jibebe-jkuat/internship2023/README.md

# Jibebe internship 2023

[PPT Slide](https://docs.google.com/presentation/d/1Ak0KLYNTehpYL2wY0T9F-hz-qm3kGaumGBHkQSi8nZo/edit?usp=sharing)

(https://docs.google.com/presentation/d/1Ak0KLYNTehpYL2wY0T9F-hz-qm3kGaumGBHkQSi8nZo/edit?usp=sharing)
