jibebe-jkuat/internship2023/mechanical/Mechanical team 5.pptx

## WEEK 5 PROGRESS REPORT

## FABRICATION OF FAN MOUNT

The fan mount fabrication and installation was completed

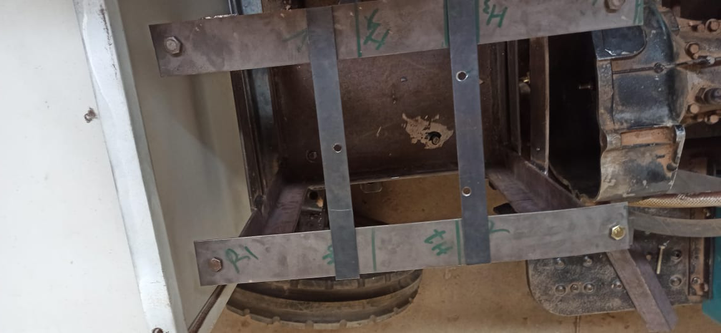
[picture p10: figure]

## Tasks this week

- Design the automated steering mechanism with navigation team
- Hydraulic pump mount and coupling

## BATTERY MOUNT DESIGN

The design was completed as shown below

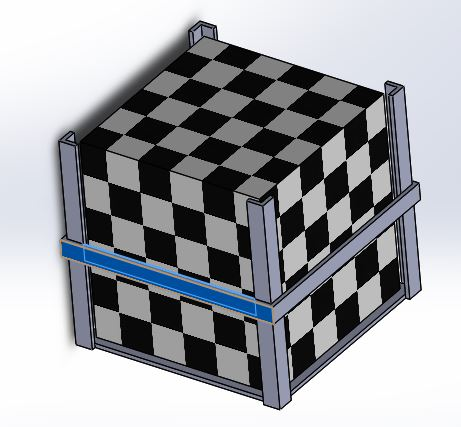
[picture p11: figure]

## BATTERY MOUNT FABRICATION AND INSTALLATION

The battery was installed with its casing for safety purposes and to minimise on material usage as shown

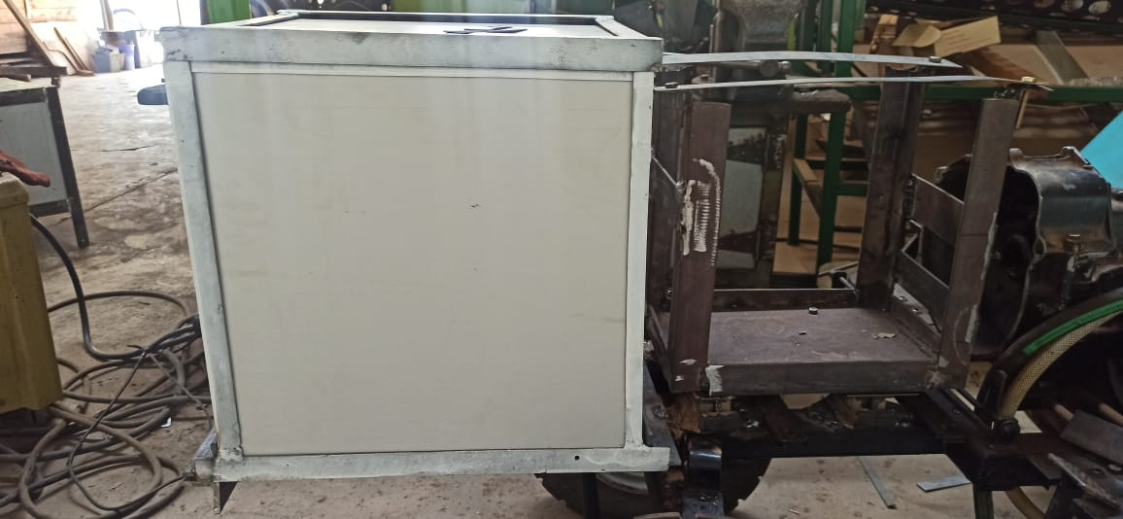
[picture p12: figure]

## EXTENSION OF THE CHASIS

The chassis was extended using a boxshaft to prevent the battery from overhanging.

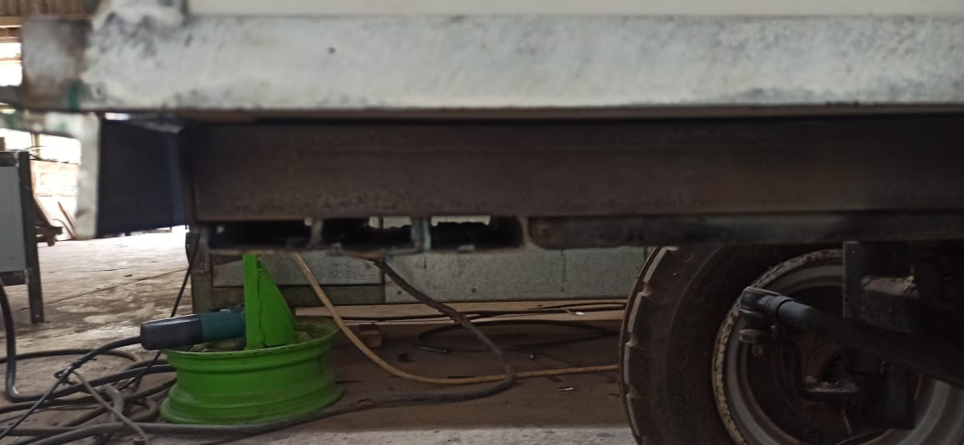
[picture p13: figure]

## ACQUISITION OF THE FLY WHEEL

The flywheel was unmounted from one of the Shujaa tractors in the BEED workshop as shown

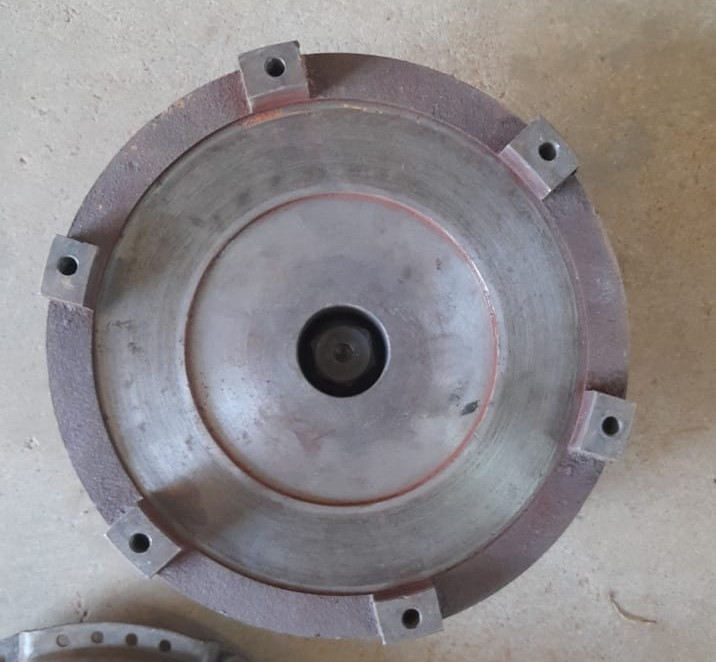
[picture p14: figure]

## 3D CAD REPRESENTATION

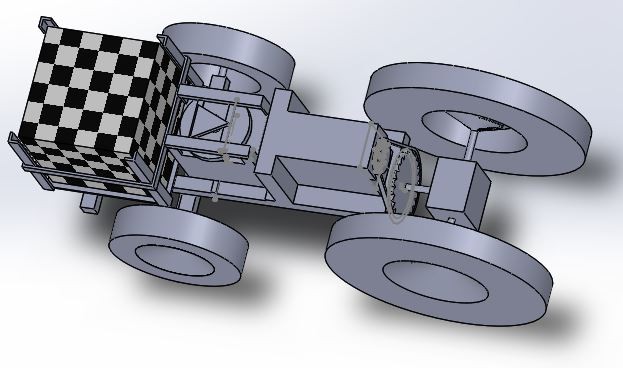
[picture p15: figure]
