jibebe-jkuat/internship2023/mechanical/Mechanical team 10.pptx

## MECHANICAL TEAM WEEK 10 PROGRESS REPORT

MEMBERS
1. Ian Mutisya
2. Isaac Ngugi
3. Peter Nzioki
4. Clinton Otieno
5. Catherine Kipkazi
6. Kennedy Ouma

## Tasks done

Wheelbase modification
Steering fabrication
Taper turning

## Taper turning

Taper was done to the flywheel-motor coupling. This was done so that it can fit into the flywheel bore.
It was done using a lathe machine in the machine shop
Key cutting is still in progress

## Wheelbase modification

By assuming the whole tractor being a simply supported beam and the wheels to be the supports, calculations were done so as to determine the new front wheel position.
We were able to extend the wheelbase by 200mm after calculations.
ASSUMPTIONS
The tractor was assumed to be a simply supported beam with the wheels as the reaction points.
The modification balanced out the reactions at the wheels to Ra=Rb to be 4.8kN.

## Slide 5

Before the modification,the reaction force at the front wheels was 5.2kN, & the rear 4.4kN. This added load to the front wheels increases tire load and steering load making turning difficult and unstable on banked road surfaces. The rear had reduced tire load increasing risk of slippage.since the tractor’s torque is transmitted to them. Reduced traction at the rear will impede operations on soft agricultural soils and in wet conditions.
Balancing of the tire load enables;
-less steering force
- pitching is minimized
-yawing chances are significantly reduced.

## FLIP ORIENTATION

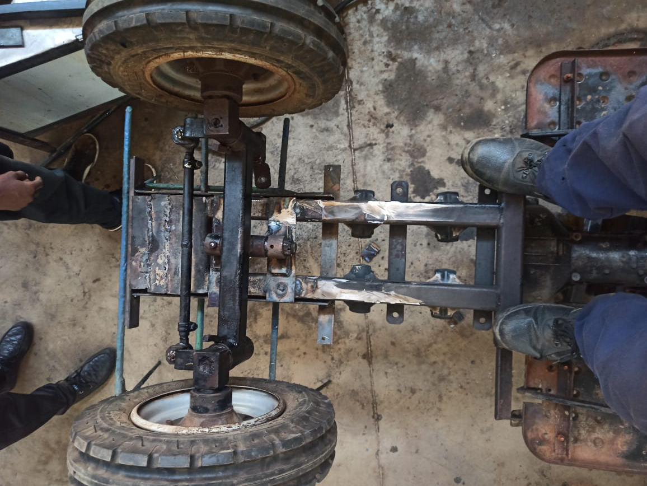
[picture p18: figure]

## TOP VIEW ORIENTATION

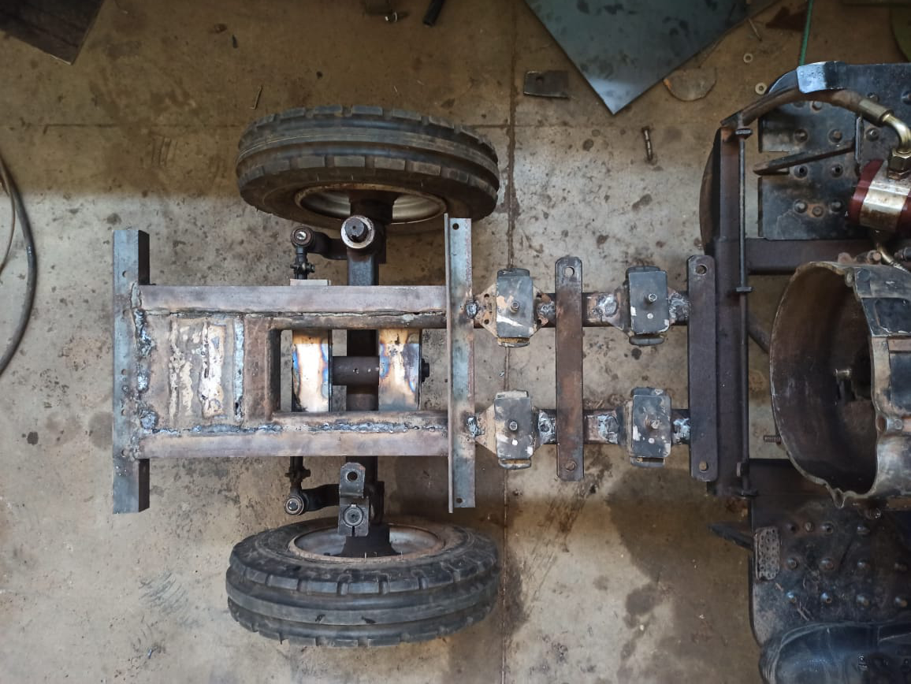
[picture p19: figure]

## STEERING INSTALLATION PROCESS

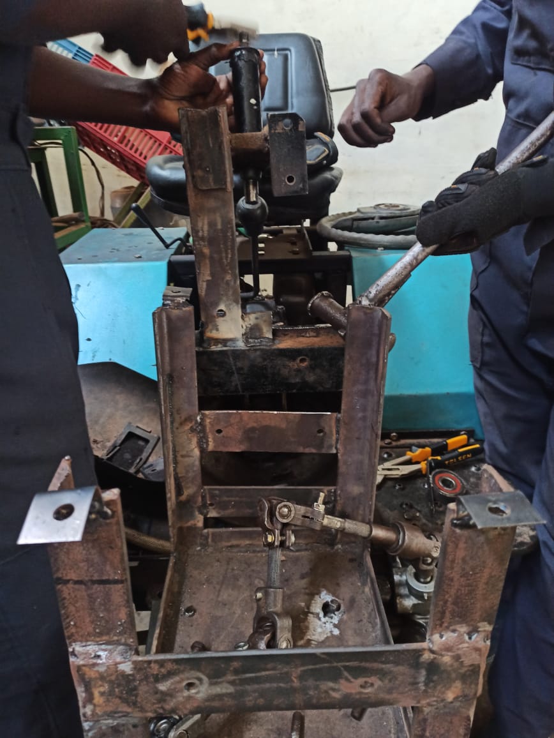
[picture p20: figure]

## STEERING

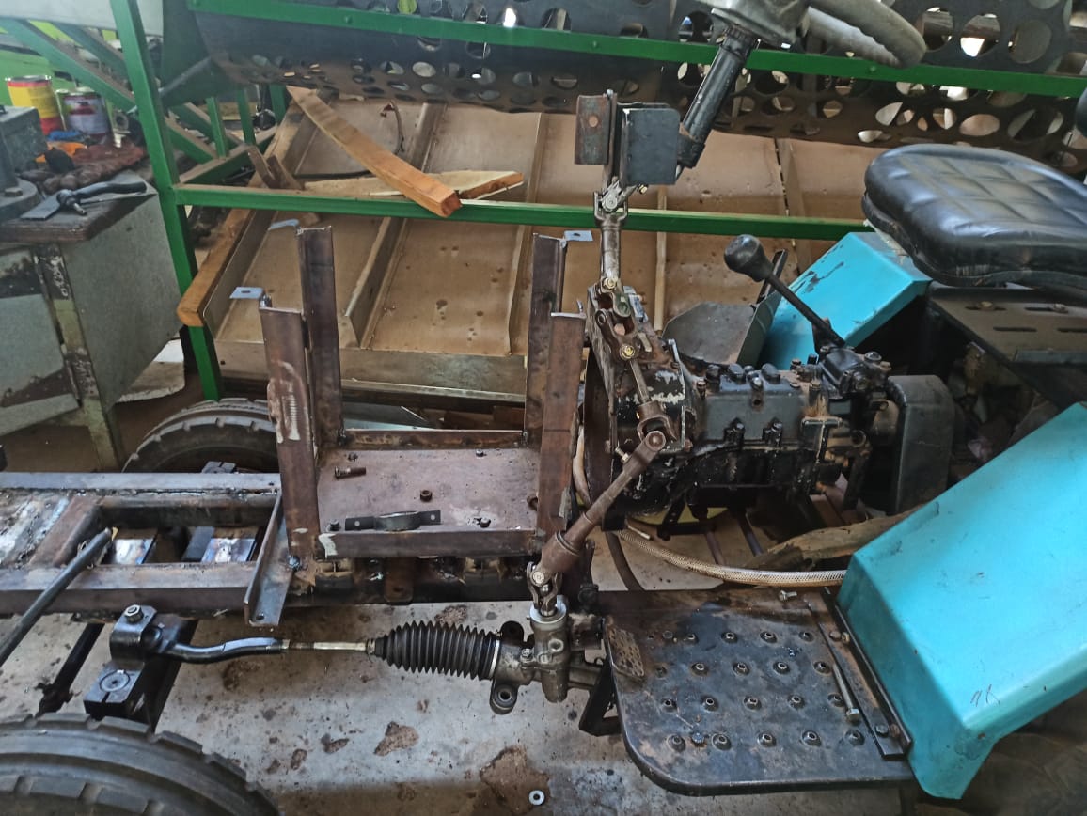
[picture p21: figure]

## KEYED AND TAPERED

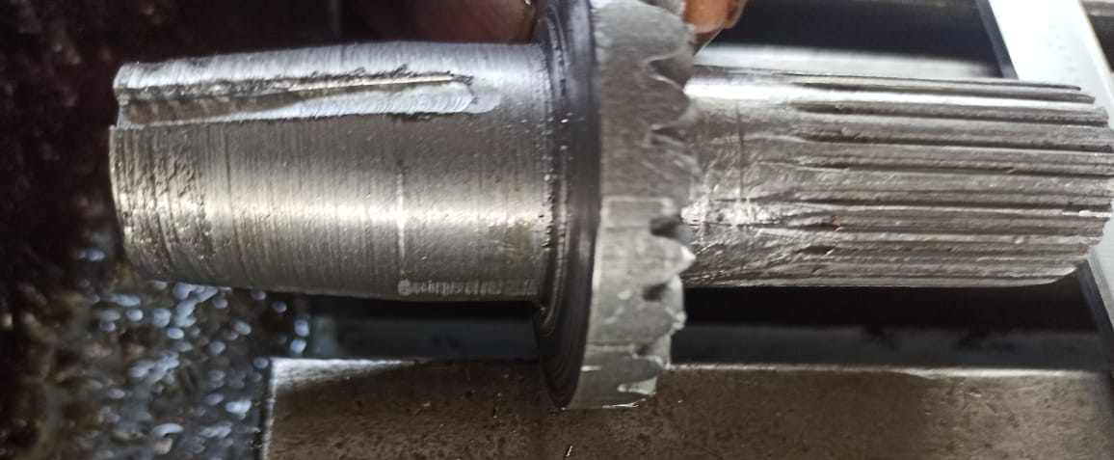
[picture p22: figure]

## Slide 11

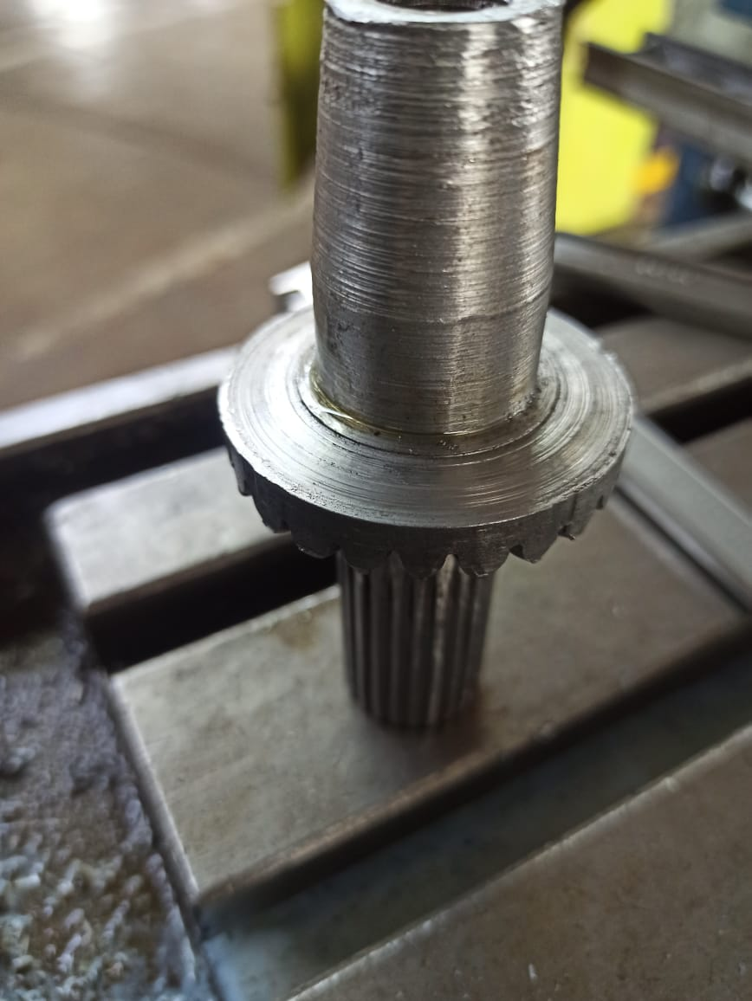
[picture p23: figure]

## Slide 12

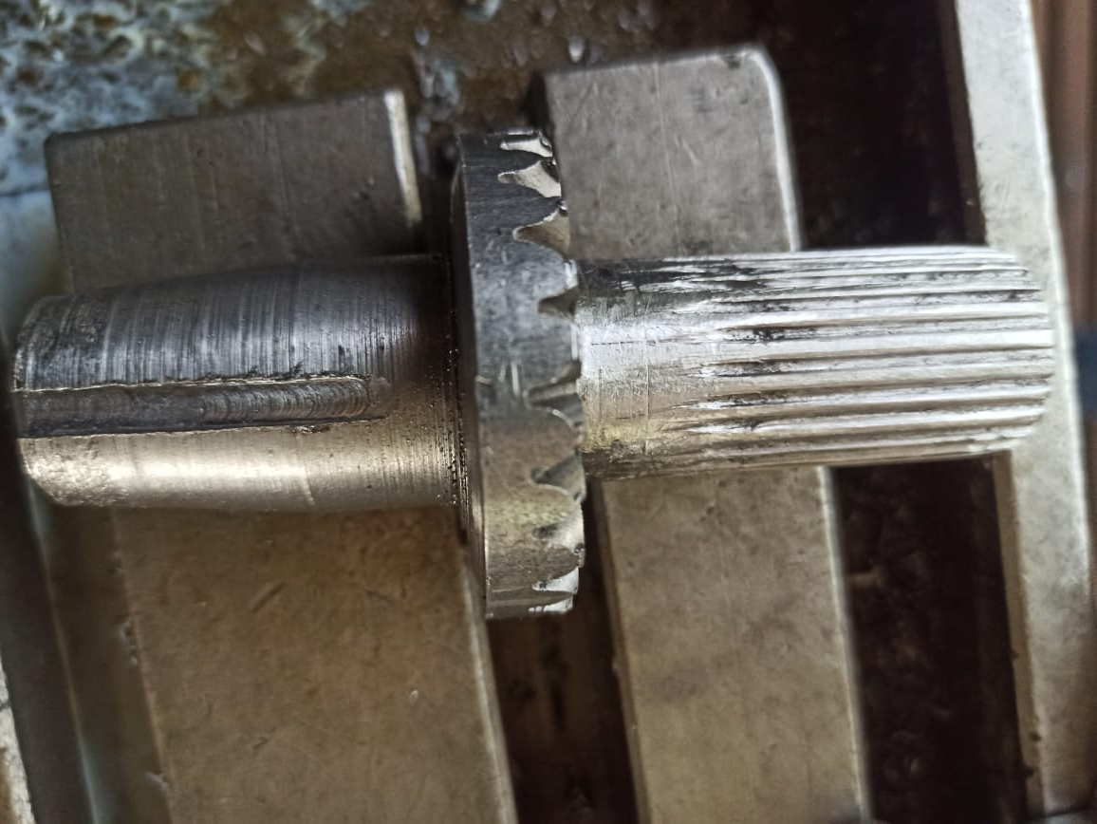
[picture p24: figure]

## Slide 13

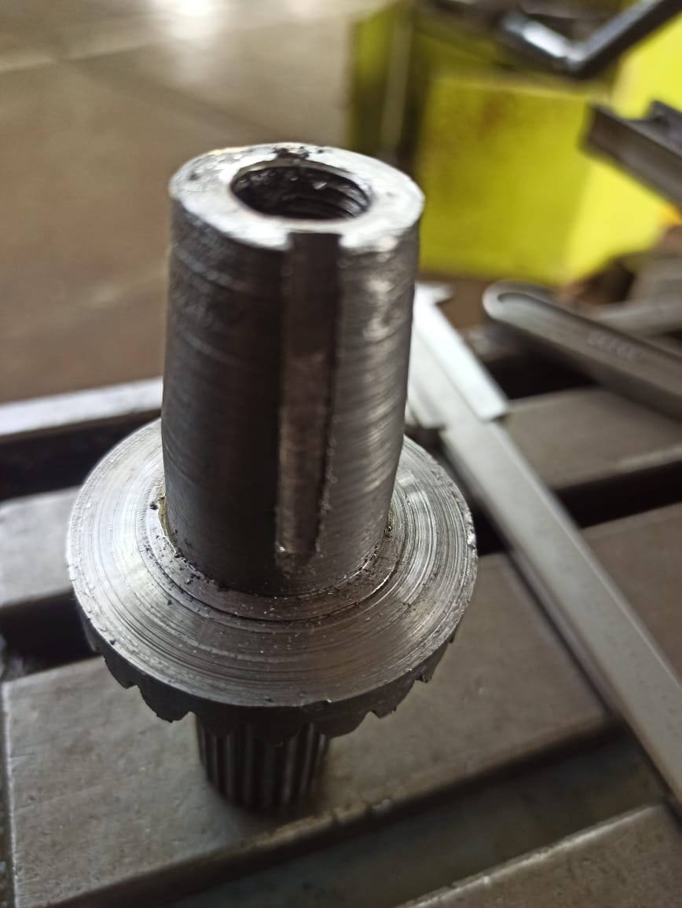
[picture p25: figure]
