jibebe-jkuat/internship2023/mechanical/Mechanical team 9.pptx

## MECHANICAL TEAM WEEK 9

Clinton Otieno

## Tasks done

Unmounting the front wheels and axle
Motor flywheel coupling machining

## FRONT WHEEL UNMOUNTING

This was done with an aim to extend the wheel base .
Extending the wheelbase will increase tractor balance thus reducing the tendency to roll when negotiating corners.

## WHEEL BASE EXTENSION IN PROGRESS

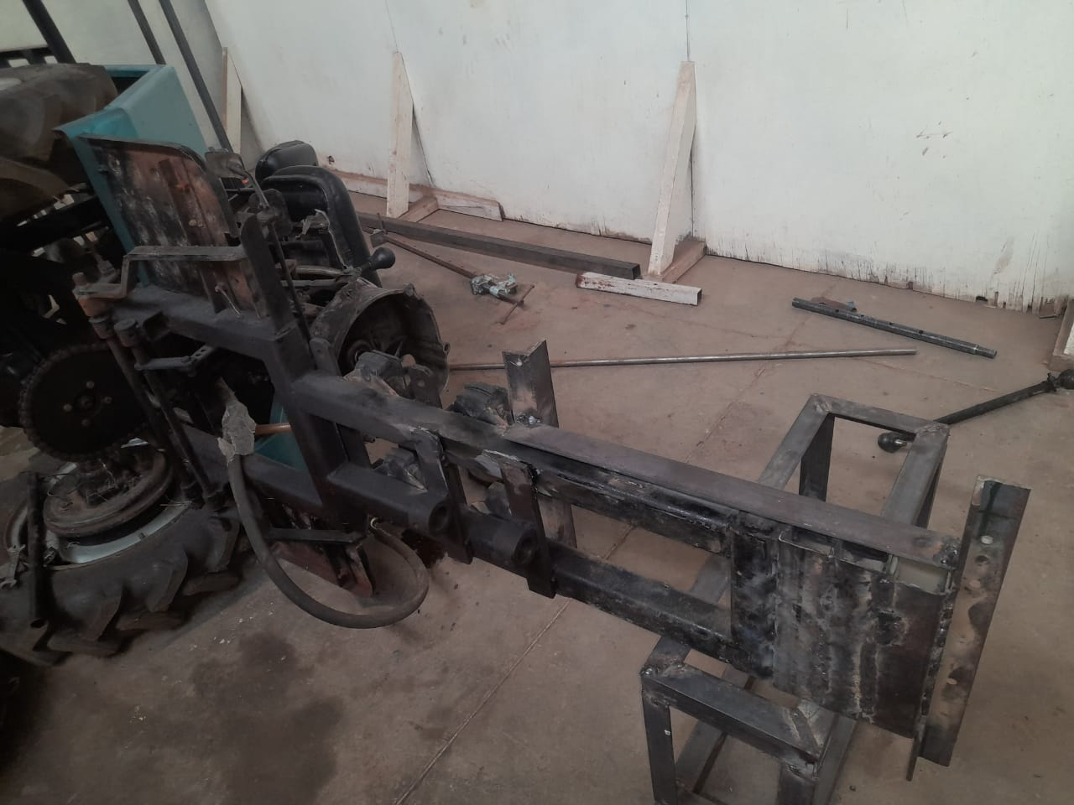
[picture p26: figure]

## MOTOR FLYWHEEL COUPLING

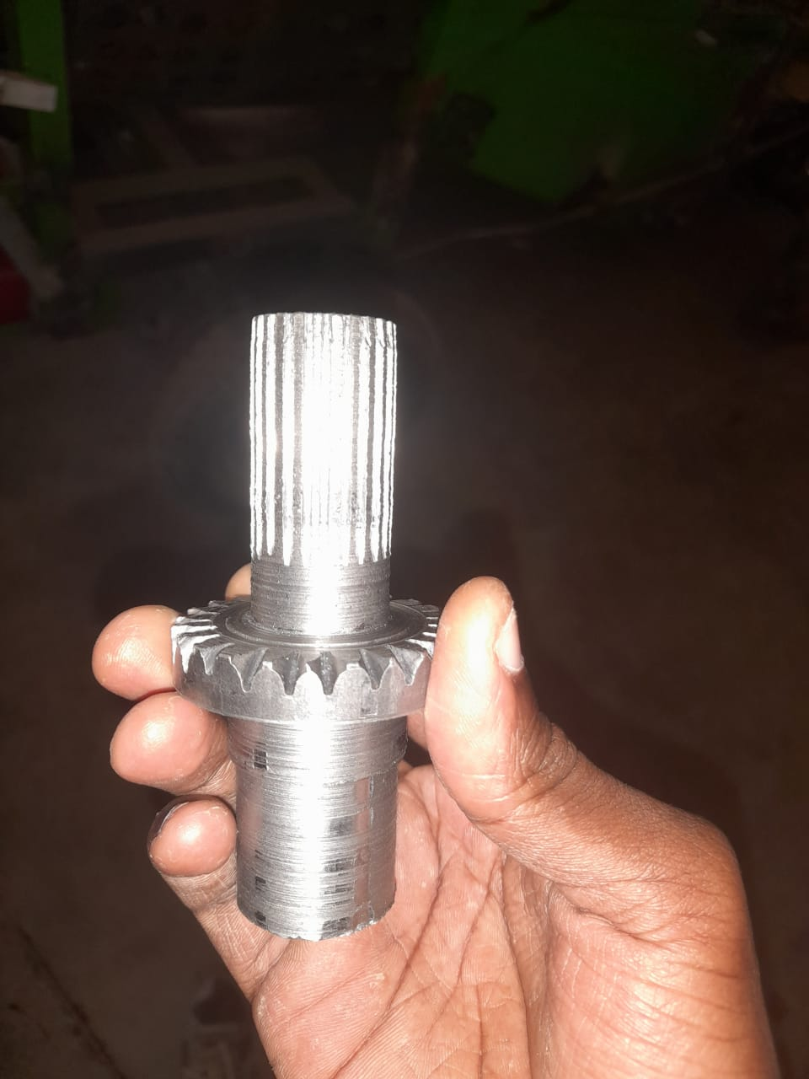
[picture p27: figure]

## FLYWHEEL COUPLING AND MOTOR

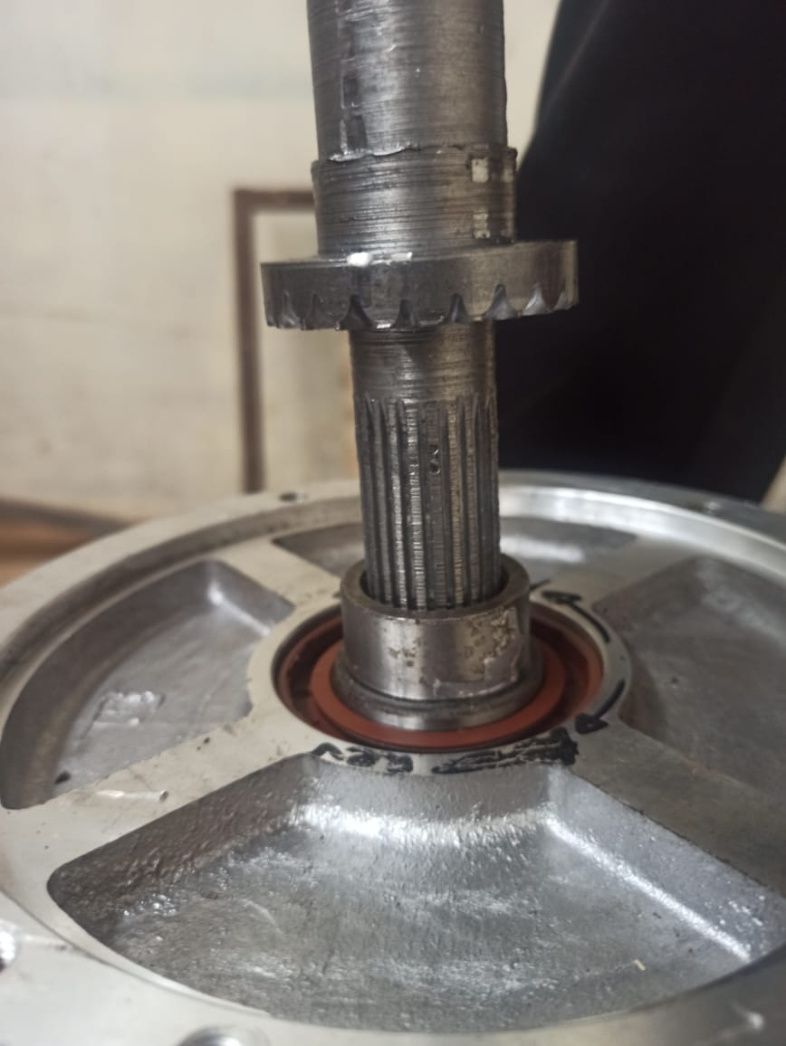
[picture p28: figure]

## THREADED PART

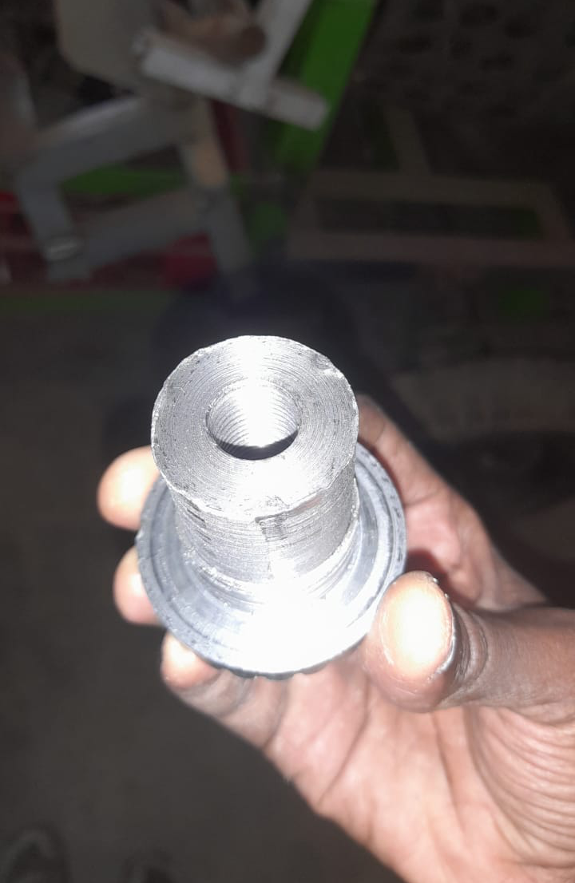
[picture p29: figure]

## MODIFIED RACK

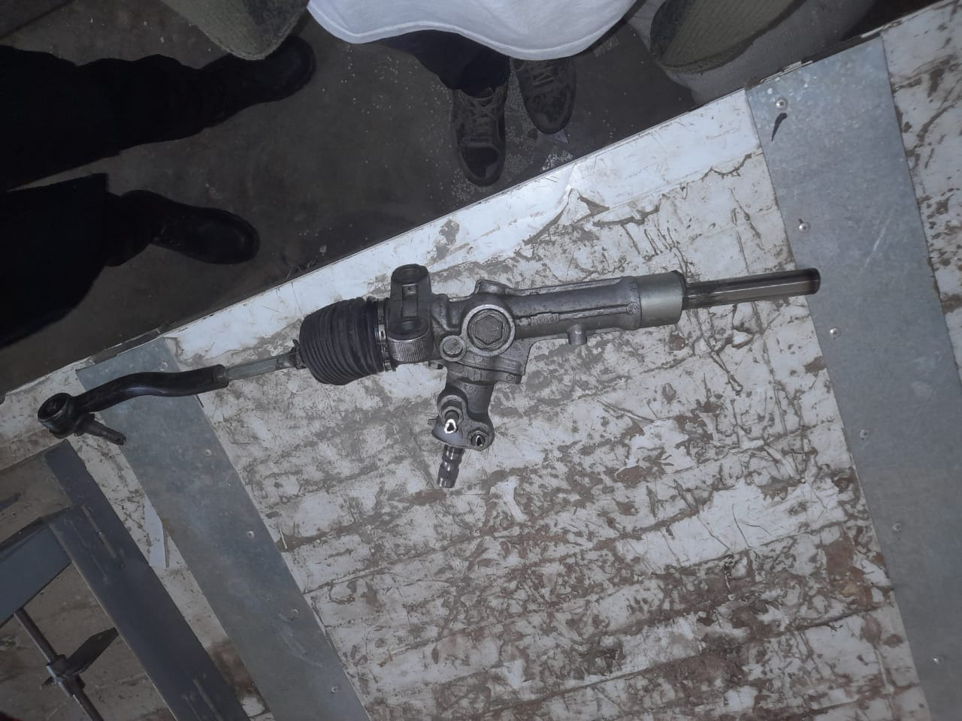
[picture p30: figure]

## CHALLENGE

Tools acquisition

## TO DO

Extension of wheel base
Finishing on the motor flywheel coupling fabrication
Completion of steering system fabrication
