jibebe-jkuat/internship2023/mechanical/Mechanical team 6.pptx

## JIBEBE MECHANICAL WEEK 6

Ian Mutisya

## TASKS COMPLETED THIS WEEK Selection of motor for hydraulic pump albeit pending calculations (will be done in consultation with electrical team). Design of new steering system Final dimensioning and design of flywheel coupling Improvement of 3D model

## HYDRAULIC PUMP MOTOR SPECIFICATIONS

We researched and found that a similar electric hydraulic pump of same capacity uses a 60W 12V motor,hence our choice power is a 70W one so as to accommodate the different implements to be used

## Slide 4

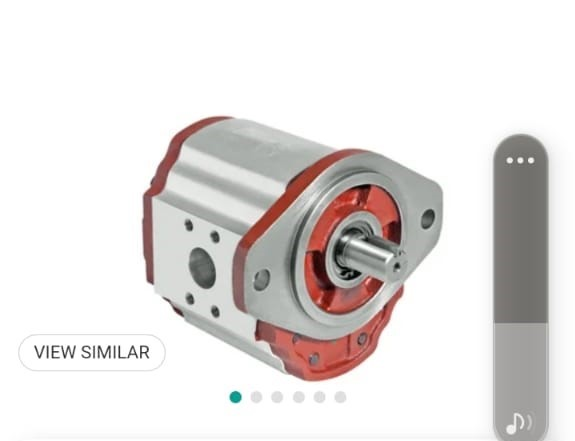
[picture p50: figure]
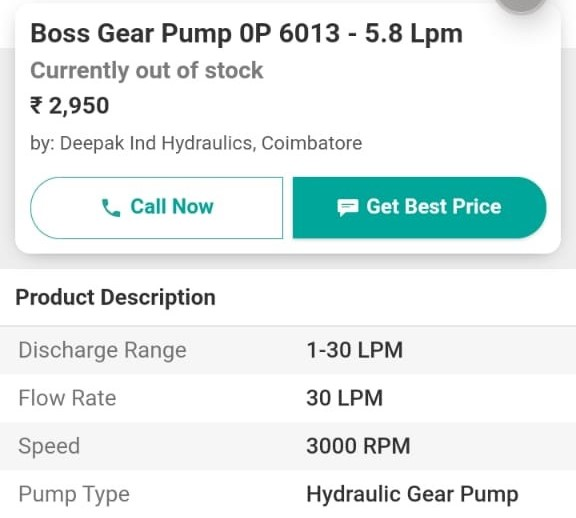
[picture p51: figure]

## Slide 5

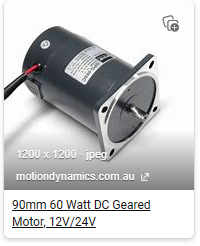
[picture p52: figure]
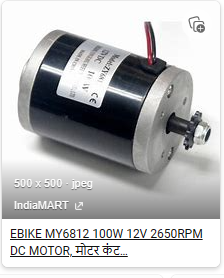
[picture p53: figure]

## STEERING DESIGN

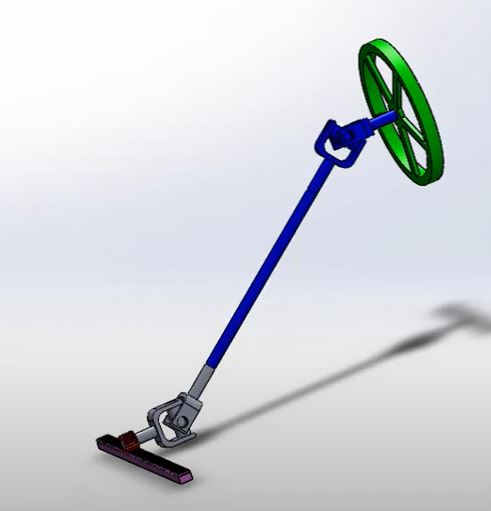
[picture p54: figure]

## WHY A NEW DESIGN?

The other steering had play leading to over steering and under steering
The battery size does not leave enough space for the previous model
The rack and pinion design allows for easier rotation of the steering wheel

## TO DO

Outsourcing the motor flywheel coupling
Hydraulic pump motor acquisition
Steering design and fabrication

## 3D REPRESENTATION

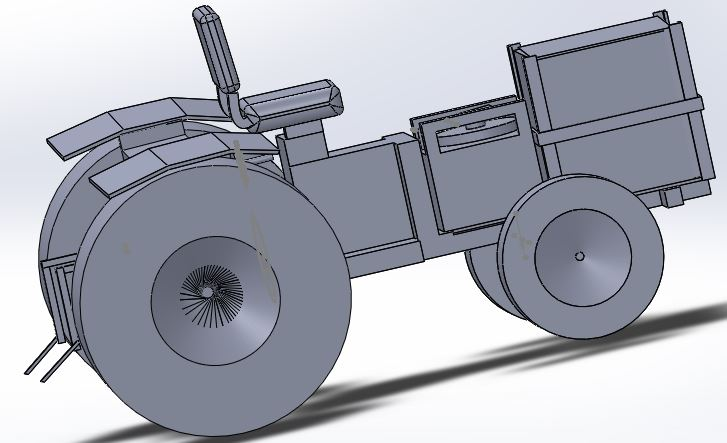
[picture p55: figure]
