jibebe-jkuat/internship2023/mechanical/Mechanical team 4.pptx

## MECHANICAL TEAM WEEK 4 PROGRESS REPORT

TEAM
CLINTON TITO
IAN MUTISYA
CATHERINE KIPKAZI
ISAAC NGUGI
KENNEDY OUMA
PETER NZIOKI

## PREVIOUS DESIGN CHALLENGE

- Had thick plates which was later realized to increase the weight the motor mount
- Use of plates on the sides obstructed air flow hence reducing cooling efficiency

## Slide 3

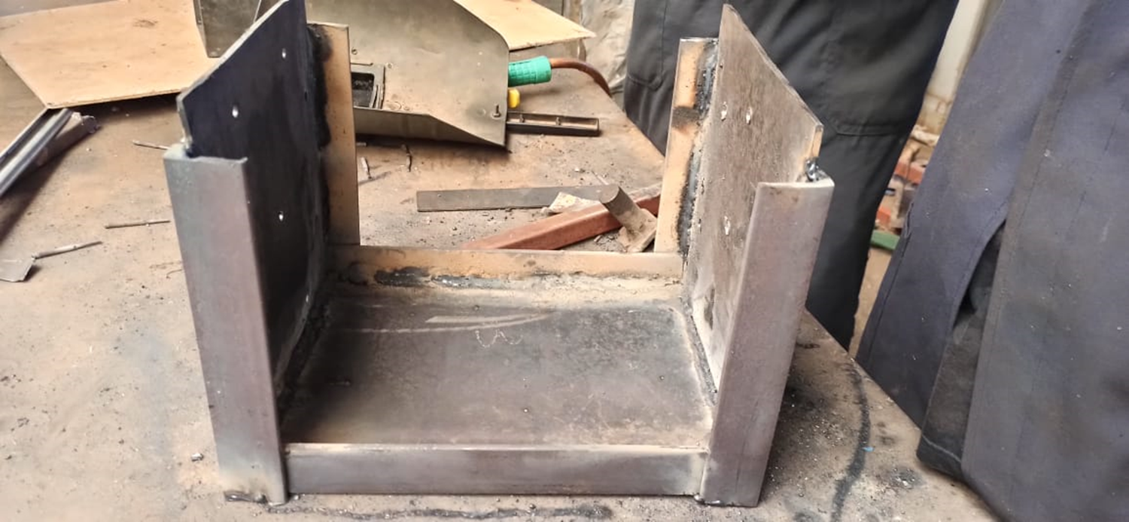
[picture p56: figure]

## WHY NEW DESIGN

- More cooling efficiency
- Lighter due to less materials as compared to the previous design

## MOTOR MOUNT WITHOUT THE MOTOR

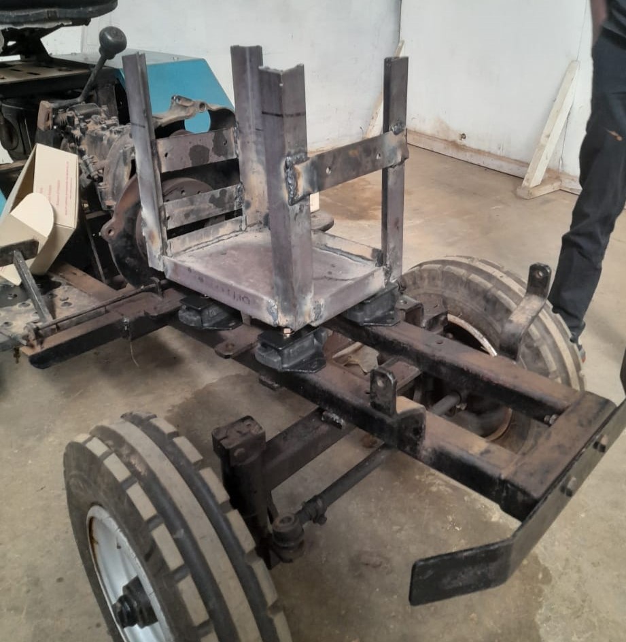
[picture p57: figure]

## SIDE VIEW

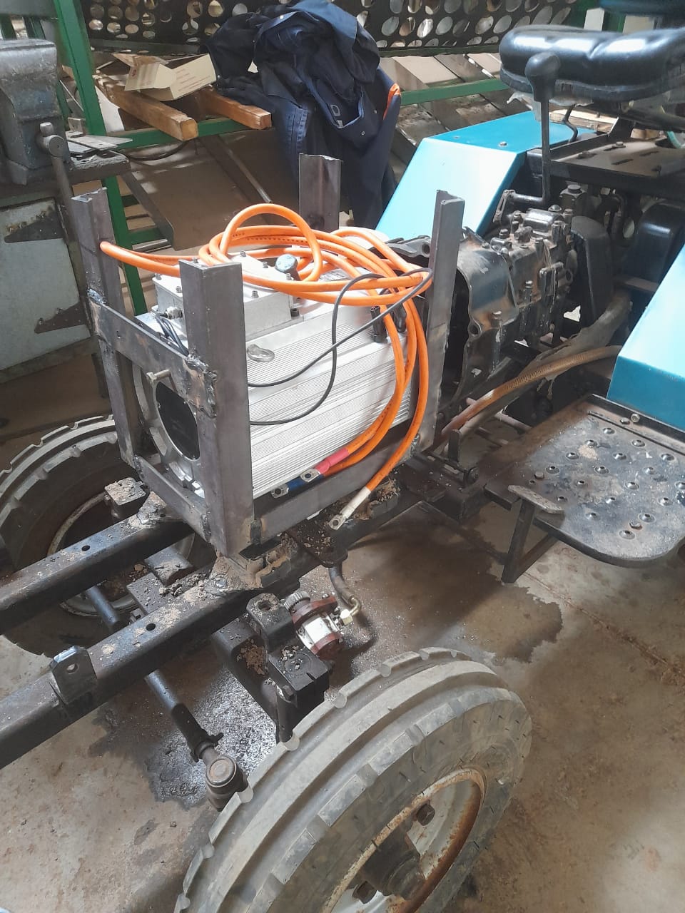
[picture p58: figure]

## RUBBER MOUNT ON THE CHASSIS

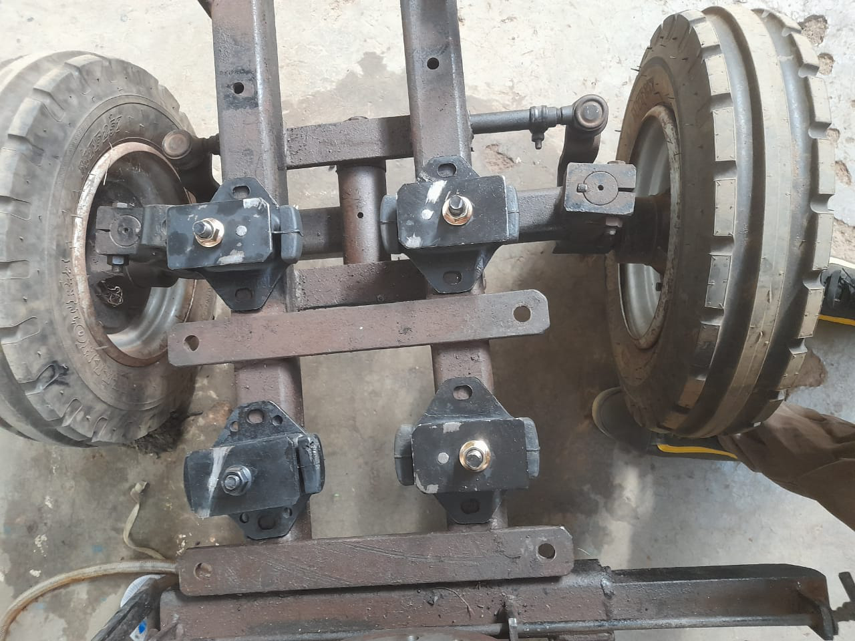
[picture p59: figure]

## TOP VIEW

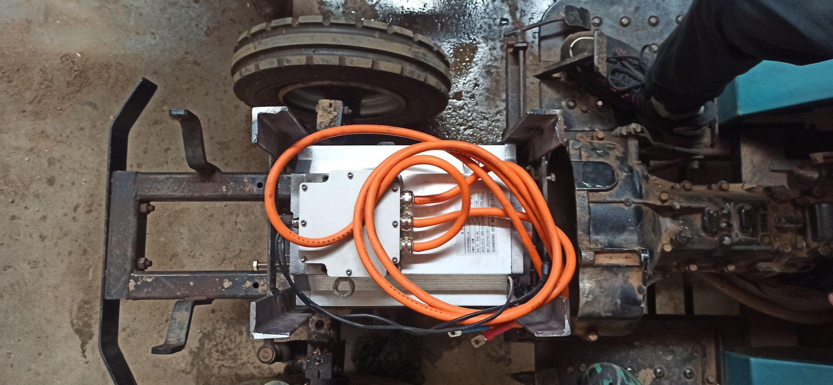
[picture p60: figure]

## FLYWHEEL COUPLING PURPOSE

To transmit power from motor to the gearbox

## FLYWHEEL COUPLING CAD DESIGN

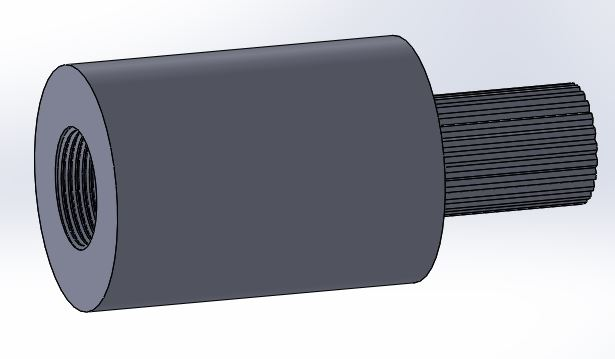
[picture p61: figure]

## TRACTOR 3D CAD REPRESENTATION

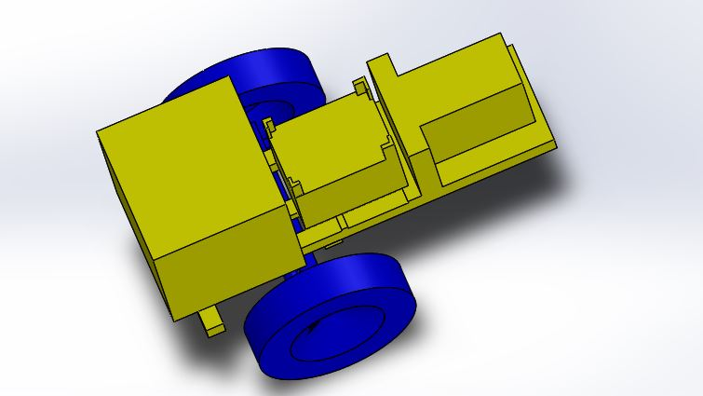
[picture p62: figure]

## THANK YOU

🤗
