jibebe-jkuat/internship2023/mechanical/Mechanical team 3.pptx

## JIBEBE MECHANICAL TEAM WEEK 3

Catherine kipkazi

## TASKS COMPLETED

Fabrication of motor mount
Fabrication of electric fan mount
Completion of final design work of battery mount

## MATERIAL ACQUISITION

We were able to acquire some materials to kickstart the fabrication process eg
Consumables
Angle lines
Plates

## FABRICATION

We began the fabrication of the motor mount.

## Slide 5

M

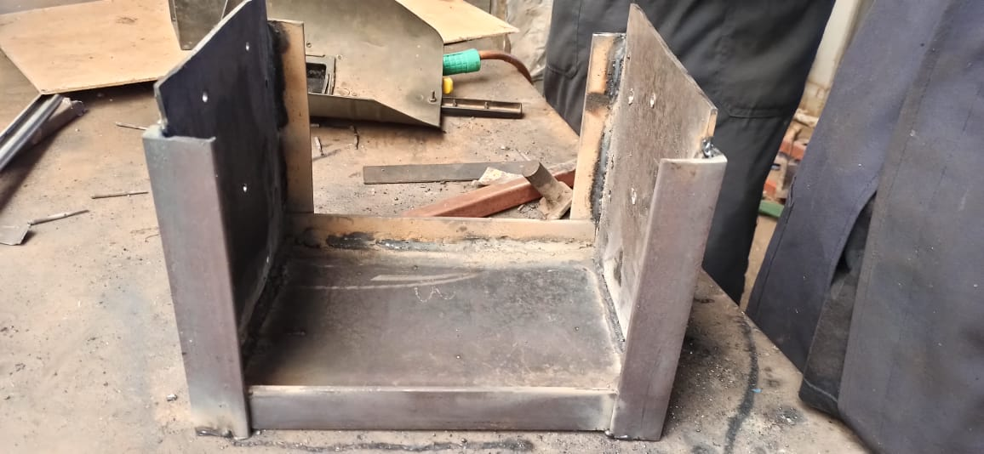
[picture p63: figure]

## TASKS THIS WEEK

Acquisition of materials
Installation of motor mount
Fabrication of battery mount
Design of flywheel-clutch coupling
