jibebe-jkuat/internship2023/mechanical/Mechanical team 2.pptx

## JIBEBE MECHANICAL TEAM WEEK 2

Kenedy Ouma

## MODIFICATION OF MOTOR AND BATTERY MOUNT DESIGN

This was to better suit the applicability ie. so that it may accomodate and support both the motor and the battery .

## Slide 3

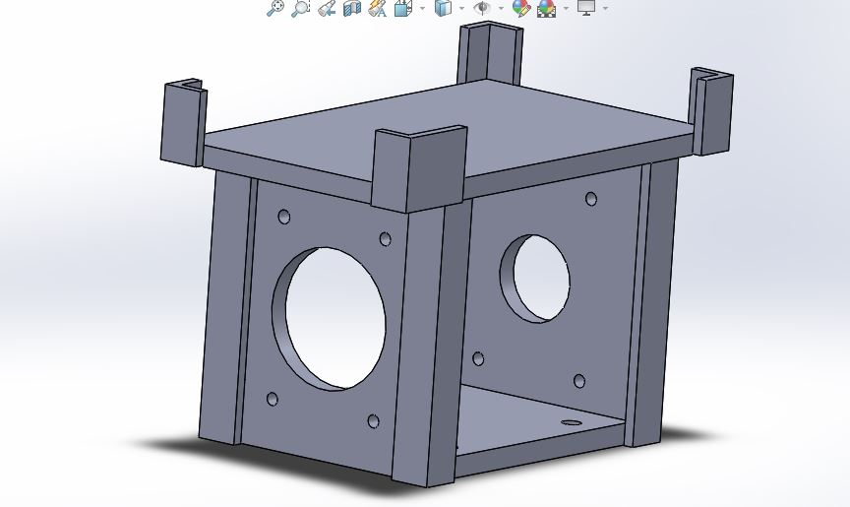
[picture p64: figure]

## Slide 4

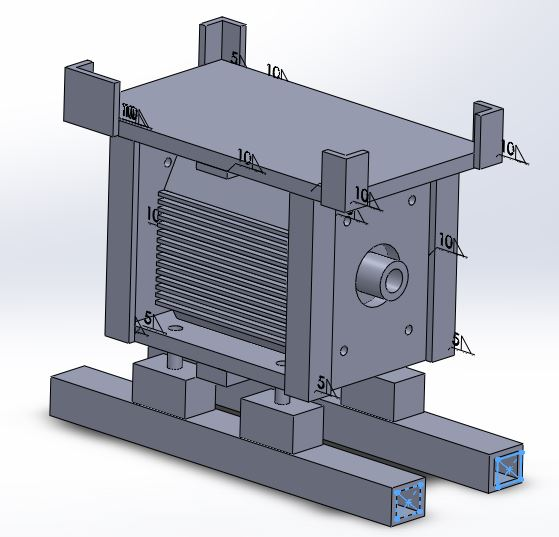
[picture p65: figure]

## SIMULATION OF THE DESIGN

From the simulation we deduced that:
The material will be mild steel
Mild steel sheets of a 20mm width
Angle lines : 2 in by 2 in by 5mm

## Slide 6

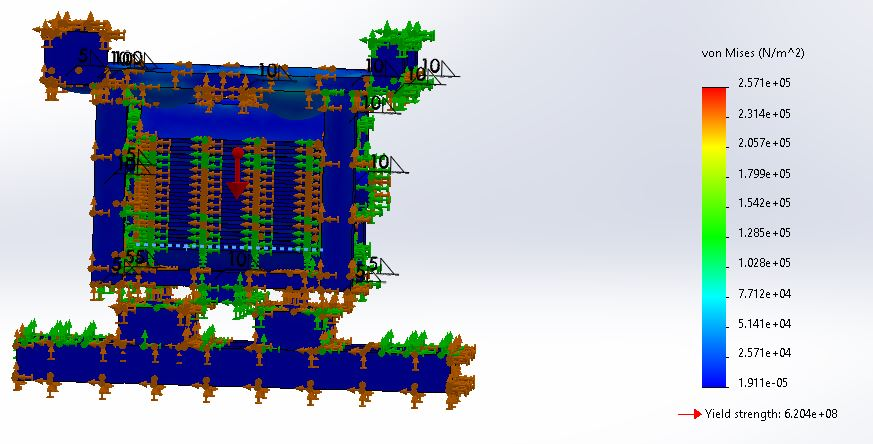
[picture p66: figure]

## Slide 7

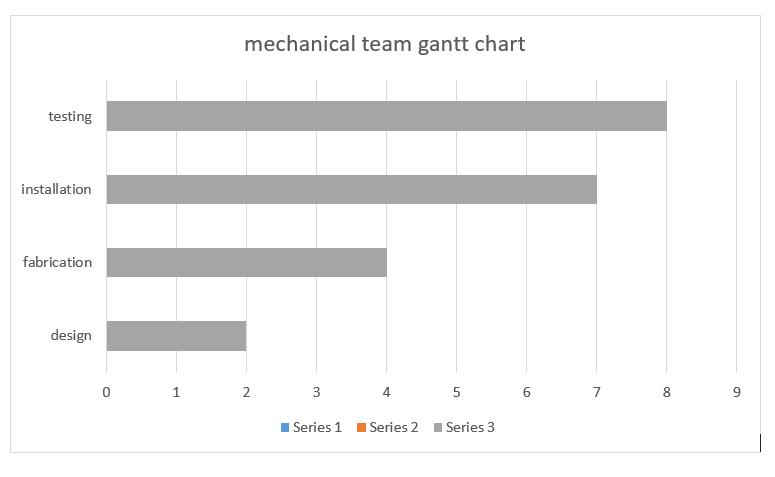
[picture p67: figure]

## ACQUISITION OF MATERIALS

We have acquired the quotations of the materials needed to kick off fabrication process

## Slide 9

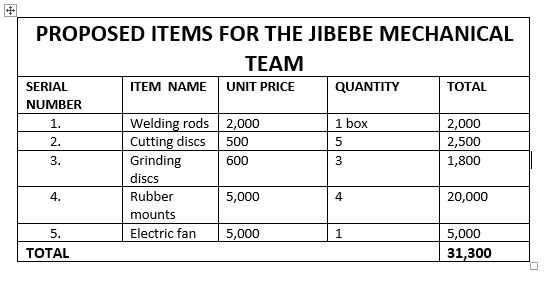
[picture p68: figure]

## Slide 10

THANK
YOU
😀
