jibebe-jkuat/internship2023/mechanical/Mechanical team 1.pptx

## JIBEBE MECHANICAL TEAM

WEEK ONE

## TRACTOR PERFORMANCE TESTING

The hydraulic and braking system were in a good condition.
The gearbox was also working properly.
Traction
- Small wheels causing insufficient traction.
Stability
- Uneven weight distribution causing a tendency to pitch or roll.
Steering
- Steering play leading to over steering and under steering.

## TRACTOR DISASSEMBLY

Unmounting the engine
Disassembling the clutch

## Slide 4

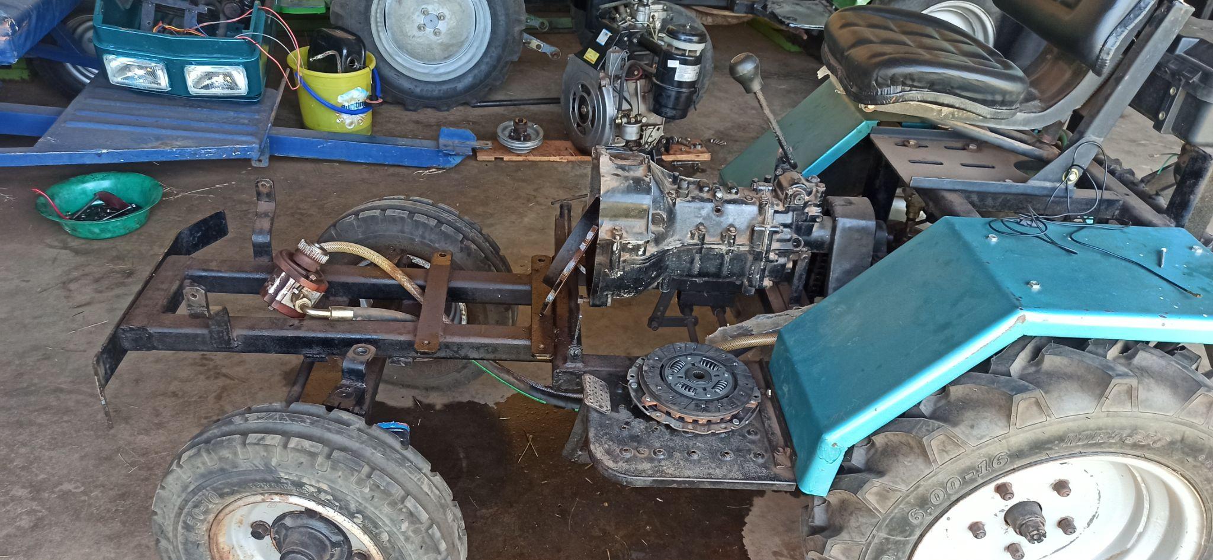
[picture p69: figure]

## Design work

- Material to be used is mild steel plate.
- Motor and hydraulic pump mounts 3D CAD designs have been done.
- Simulation is in progress.

## MOTOR MOUNT 3D CAD DESIGN

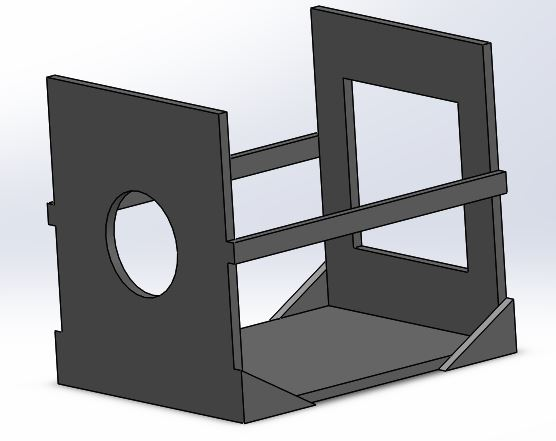
[picture p70: figure]

## HYDRAULIC PUMP MOUNT 3D CAD DESIGN

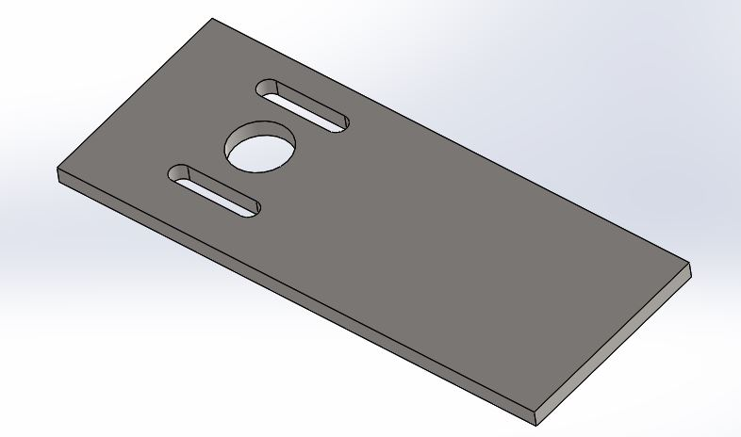
[picture p71: figure]
