jibebe-jkuat/internship2023/electrical/Electrical team 1.pptx

## JIBEBE PROJECT 2023

<ELECTRICAL SUBSYSTEM>

TEAM :
- EUNICE ORENGE
- LABAN MWANGI
- VICTOR MAINA
- STEPHEN KINUTHIA

## OBJECTIVE

To design and fabricate the electric system for an electric tractor

## MAJOR COMPONENTS

- A.C MOTOR 15kW, 3000 rpm
- 96V Slider ACIM Controller
- 96V 165Ah Battery
- Charging system

## OPERATION

- The first step to operate the electric tractor is to turn it on through the ignition.
- This action activates the controller to allow power flow to the electric motor.
- The tractor is still stationary and upon application of the either the travelling , reverse and working gears then pressing the accelerator , the tractor starts moving.
- The travelling gear moves the tractor at high speed and low torque, favorable for movement in a smooth surface for example, a tarmac road.
- The reverse gear moves the tractor in the opposite direction.
- The working gear moves the tractor in low speed but high torque, favorable for tilling.
- All these operations are managed by the controller which acts as the brain of the motor. It also inverts DC voltage from the battery to AC

## Power flow-chart

Battery

Motor controller

Motor

Source from Socket

Low Voltage DC Converter

Lights and indicators

Navigation systems

## testing

## testing

a. Battery testing
b. Motor testing

## A) BATTERY TESTING

- Charging of the battery has not been tested since cable lugs are yet to be acquired.
- The discharging of the battery is also yet to be determined, such that we know just how long it will take to discharge the battery.
- There is a thought in the pipeline of incorporating a regenerative braking system that recharges the battery as the motor slows down, though a lot of research still needs to be done on the subject.
- The output terminals of the battery were measured to be 106V DC.

## B) MOTOR TESTING

The motor testing was sub-divided into the following
1. Speed test
2. Braking test
3. AC output voltage of the controller
4. Navigation modes test

## 1.SpEED TEST

The speed of the motor was noticed to be relatively low after the installation/connection of the motor and this was first solved by interchanging the U and V phases which gave us an output speed of 4500rpm.
Later on, we interchanged the V and W phases and got a higher speed in relation to the previous speed. Though, we are yet to measure this speed. We are planning for the acquisition of the analogue tachometer from the Machines Lab to facilitate this measurement.
The speed test proved successful and we can bring it to a close after examining that there are no more possible ways to increase the output speed of the motor further

## 2. BRAKING TEST

The testing of the braking system of the motor with the controls of the controller is still failing. We endeavor to re-check the connections and troubleshoot in subsequent tests.

## 3. THE OUTPUT OF THE CONTROLLER

At first the output measured from the controller was 23V AC line to line. After interchanging the V and U phases in a bid to increase the output speed, the output of the controller was noticed to have increased to 26V AC line to line.
A later interchanging of the phases to W and V causes an increase on the output voltage to a peak of 60V AC line to line and a constant of 50V AC when the throttle is accelerated to the maximum.
The team is yet to investigate the theoretical knowledge or principle behind this behavior of the motor and controller, as all this information was arrived at after reading through the manual on the ACIM controller.

## 4. NaVIGATION MODES

There are three modes namely, forward , reverse and half speed.
The testing of all three was successful and though the interchanging of the phases caused a switch in the working of the reverse and forward modes, such that a command to move the motor in the forward direction moved it in reverse and vice-versa, the team was able to find a way around it and the test was brought to completion successfully.
