jibebe-jkuat/internship2023/navigation/Navigation team 8.pptx

## Navigation Group.

Week Eight Progress Report.

## GPS Module Inconveniences.

- Upto last week, we had good progress on the pinging of lattitude and longitiude coordinates. Since Monday this week we have trouble in picking up any ping from the satelites. Primarily, we have considered changing the GPS module in totailty as it derails our progress tremendously.
- Hoping to have already configured the motors, the GPS module seems to have faulty response in returning any coordinates and as such only the motors are receiving any power from the mor shield.
- In full context of the total inconveniences, we have also discovered the disfunctionility of the motor shield in providing power to the arduino mega board. We had presummed that through the motor shield, power would be delivered to the Mega board. Instead the board was the one supplying to the motor shield and not viece versa.

## Remedies discussed.

1. Change of the GPS module with also the passive antenna with a better GPS and an Active antenna.
2. Purchase of a two port to one port adapter to feed the board first then the power will reach the motor shield. This was actually done through obstacle avoidance albeit with an adapter cable from the wall which limited the movement distance.
3. Providing a video of proof of concept with attached functionality of the magnetometer and communication to the robot through MQTT.

## MQTT communication Protocol.

- Wireless Communication with Arduino
- MQTT - a protocol for IoT devices
- For testing we set up the mosquitto server on our PC. The esp connects to the server as a client so does the web app that would be sending the requests.
- Both clients connect to the same topic say for example "test"
- The client sending the message publishes a message through the topic test.
- Here is an example. executed through the terminal
- mosquitto_pub -t "test" -m "gps coordinates"
- the esp then, already subscribed to the "test" topic receives the coordinates and assigns them to variables target_lon and target_lan
- So far we have been able to connect the esp 32 to the mosquitto server and have confirmed reception of published messages.
