jibebe-jkuat/internship2023/electrical/Electrical team 8.pptx

## Week 8 progress report

Group members
Eunice orenge
Laban mwangi
Stephen kinuthia
Victor ngatia

## OBJECTIVES

- Redesign the PCB
- Simulate the circuit
- Consult Nakuja team on where to print the PCB
- Come up with a list of components and their prices

## simulation

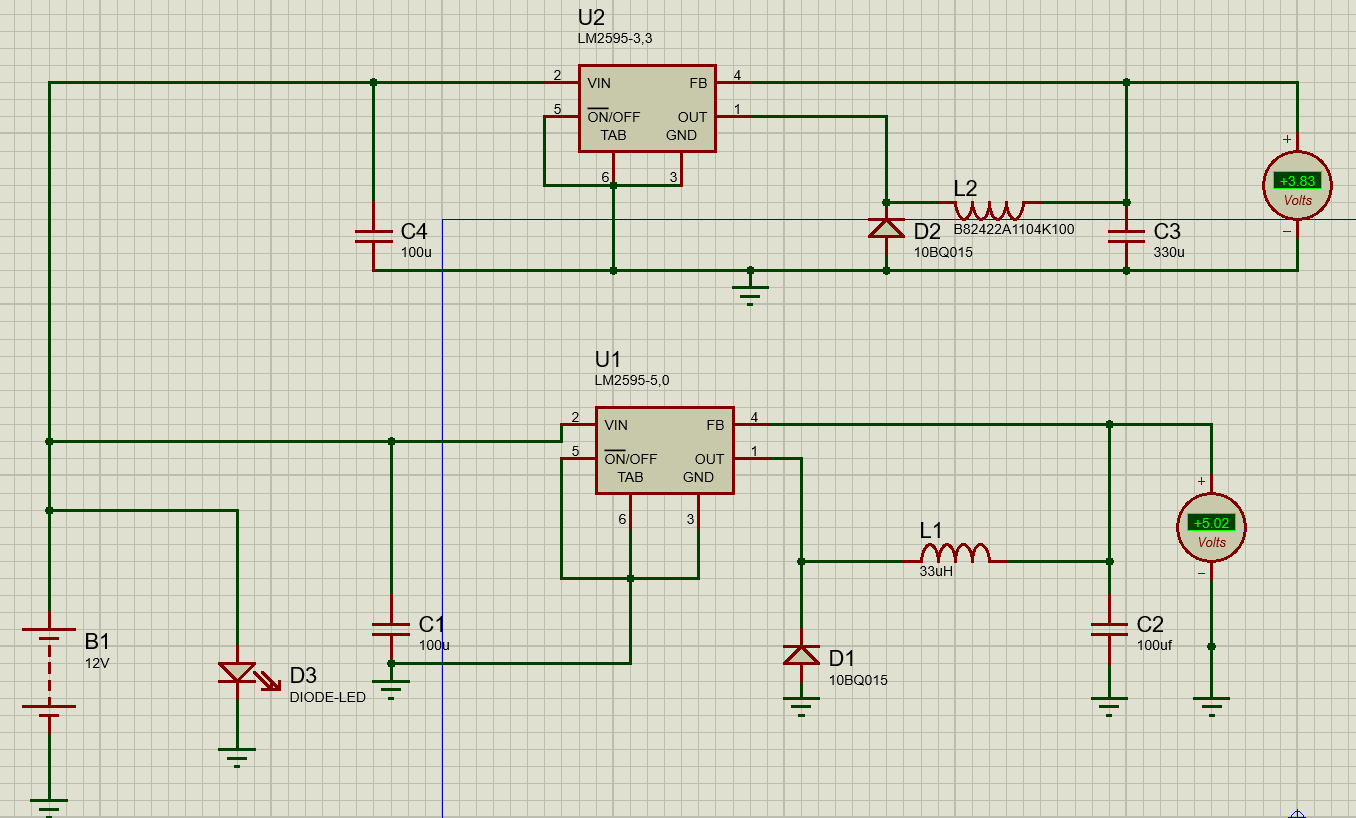
[picture p83: figure]
Screen Clipping
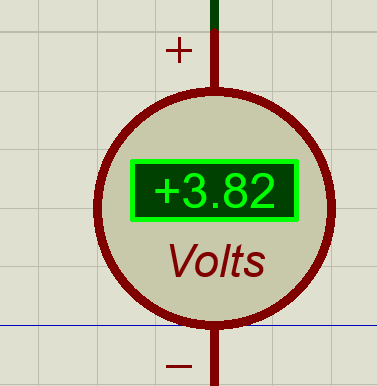
[picture p84: figure]
Screen Clipping
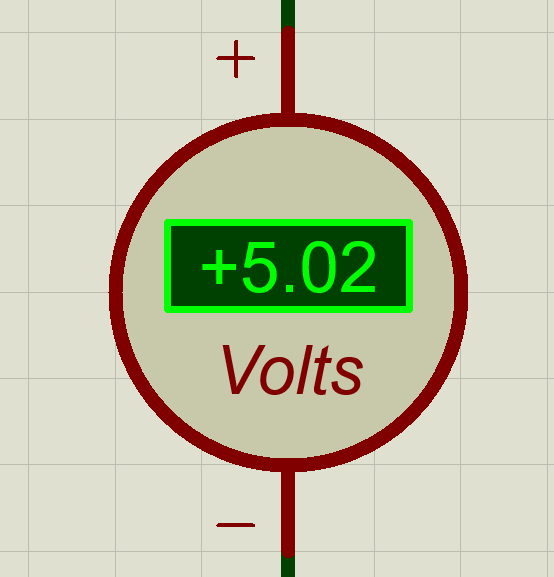
[picture p85: figure]
Screen Clipping

## Schematic diagram

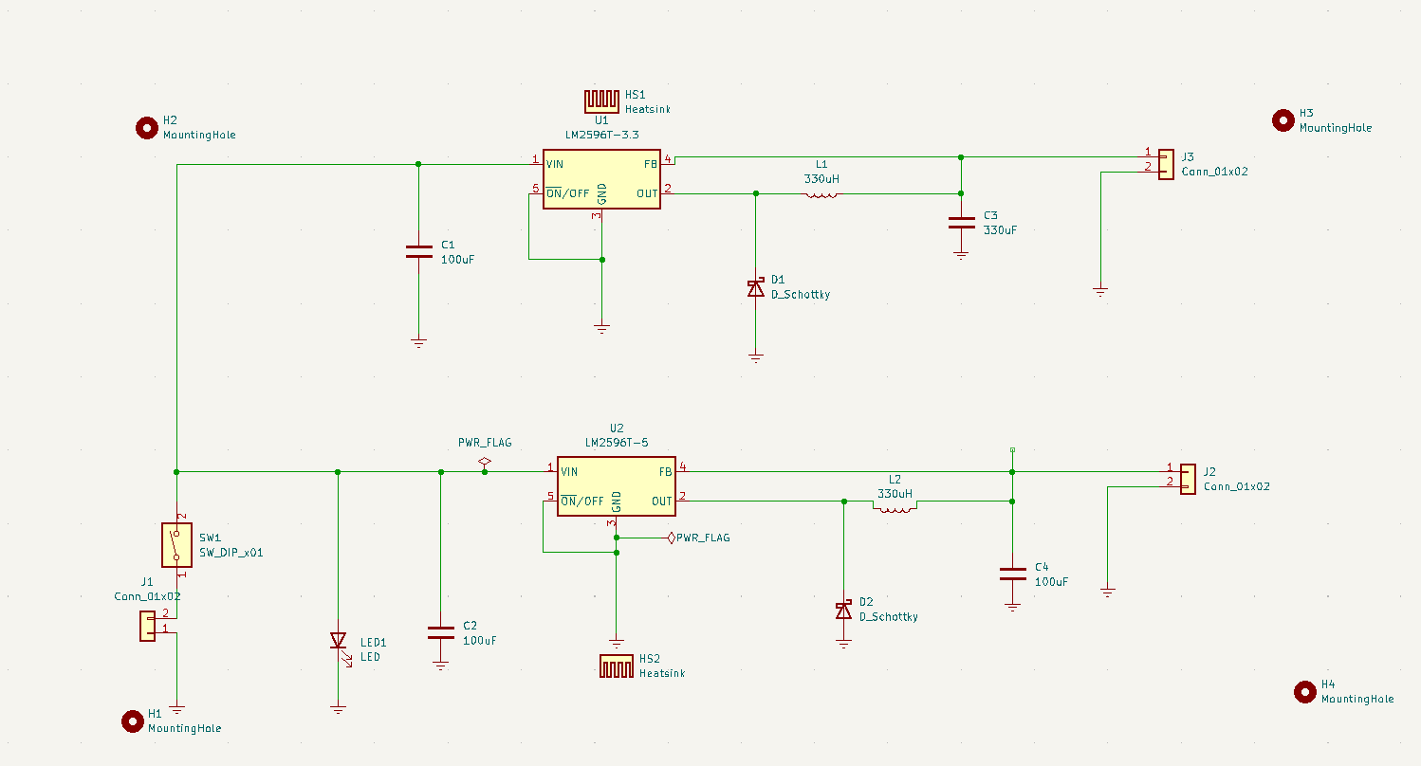
[picture p86: figure]

## PCB DESIGN

LM 2596S

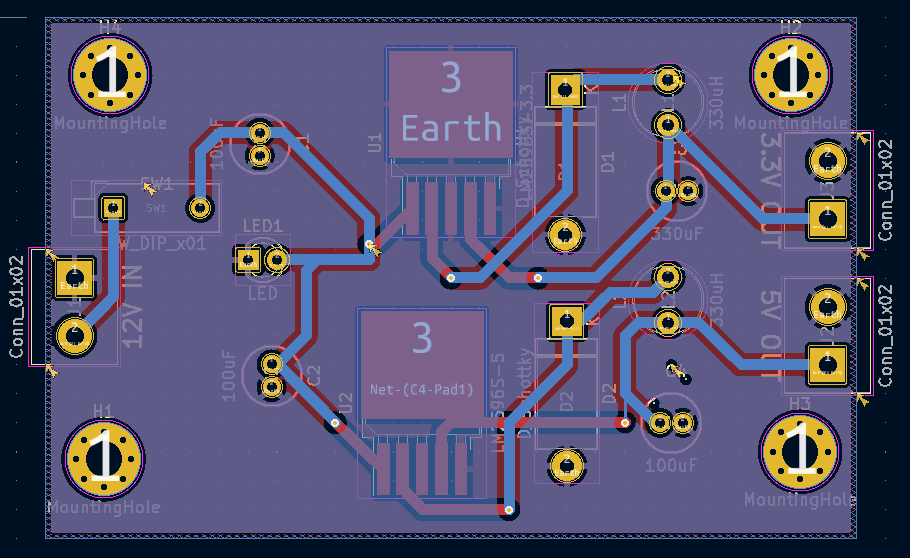
[picture p87: figure]
Screen Clipping

LM 2596T

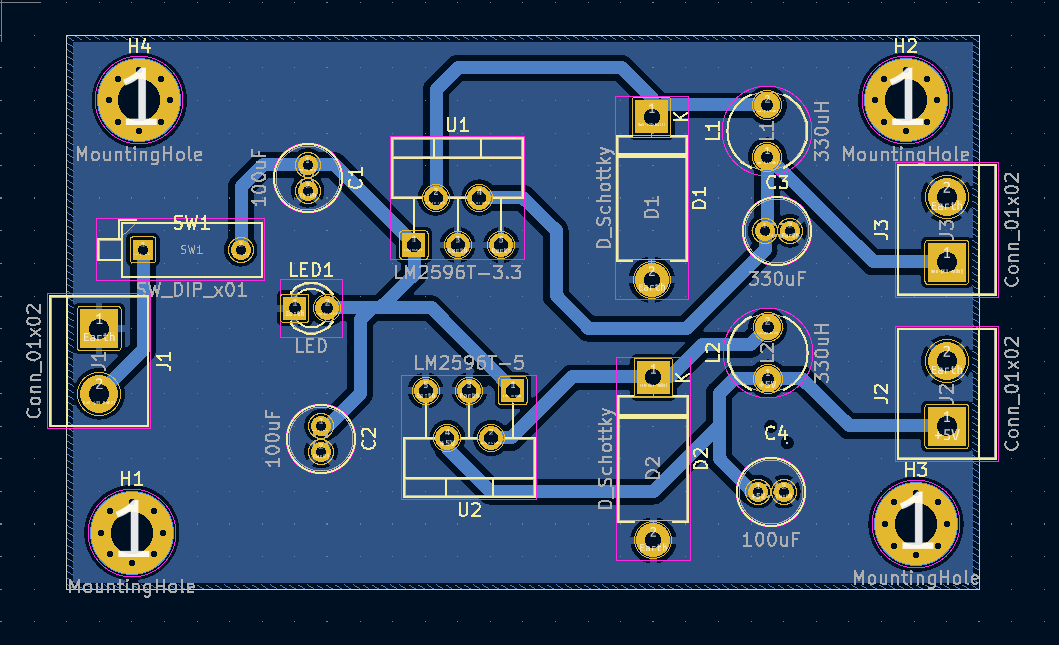
[picture p88: figure]

## 3D MODEL

LM2596T

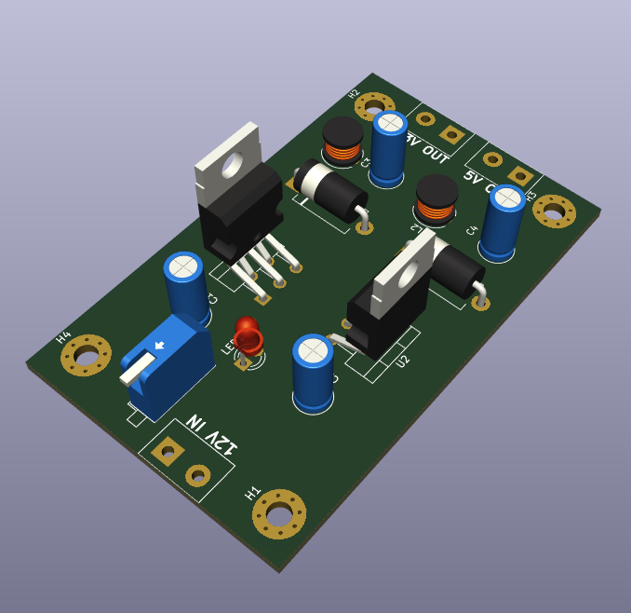
[picture p89: figure]
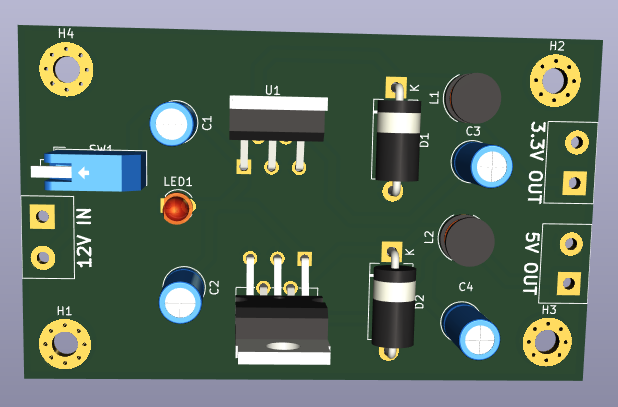
[picture p90: figure]

## 3d design

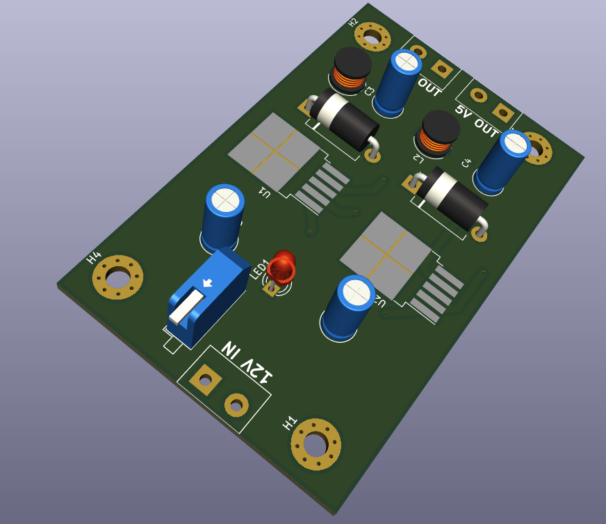
[picture p91: figure]
Screen Clipping
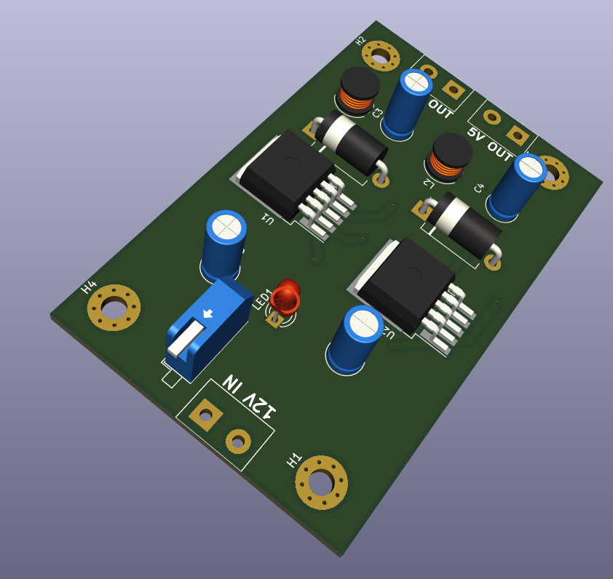
[picture p92: figure]
Screen Clipping

## Price of components

ITEM | QUANTITY | PRICE | TOTAL
LM 2596 5.0 | 1 | KSH 50 | KSH 50
LM 2596 3.3 | 1 | KSH50 | KSH 50
100 μF Capacitor | 2 | KSH 5 | KSH 10
330 μH Inductor | 2 | KSH25 | KSH 50
Schottky diode | 2 | KSH 20 | KSH 40
Screw block connectors 1*2 | 4 | KSH 15 | KSH 60
LED light(12v) | 1 | KSH 50 | KSH 50
330μF Capacitor | 1 | KSH 20 | KSH 20
| | | KSH 330

## Slide 9

OBJECTIVES FOR THE NEXT WEEK

- Purchase the necessary components.
- Fabricate the PCB
- Mount and solder the components.
- Test the Buck Converter

## Slide 10

THANK YOU
