jibebe-jkuat/internship2023/navigation/Navigation team 6.pptx

## Navigation Group

Week six progress and tasks

## Members

- Members;
1. Dennis Bundi.
2. Charles Otieno.
3. Kiragu Maina.
4. Omar Waka.

## Path Generation Software

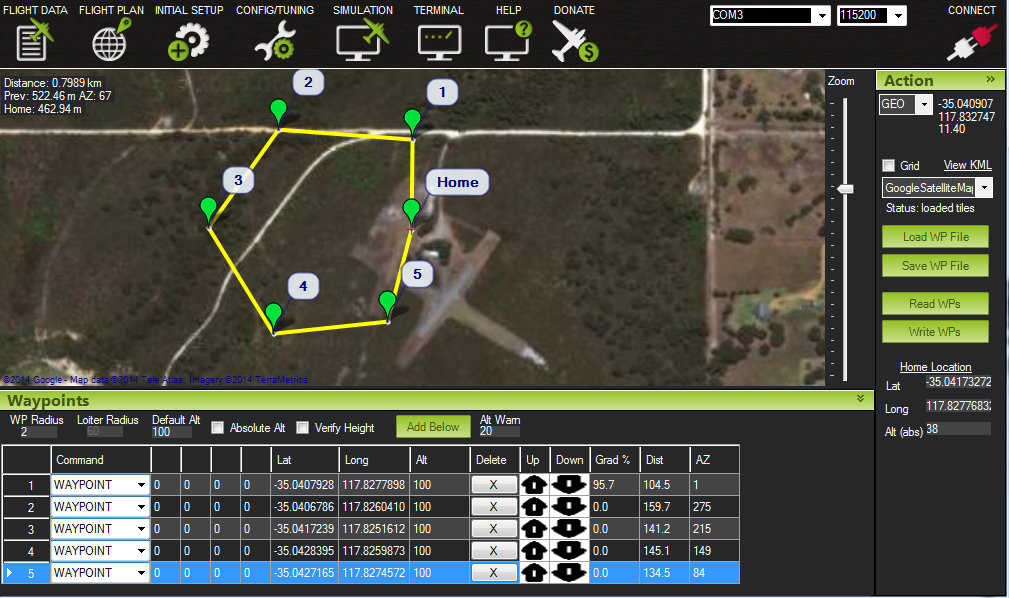
[picture p99: figure]

## Motor Signal generation

Use of GPS coordinates as target points to be fed into the tractor from the internet or via LAN.
Tractor capturing its own GPS signals and generation of the path of best fit between the destination and the current location.
Determine any form of deviation in its current course and adjusts appropriately.
It uses PID (Proportional Integral Derivative) Control loop feedback mechanism for error compensation to get to its final point.
The RaspberryPI microprocessor module will handle most of the calculation and processes and use the Arduino microcontroller to carry out the task.

## Motor Signal generation

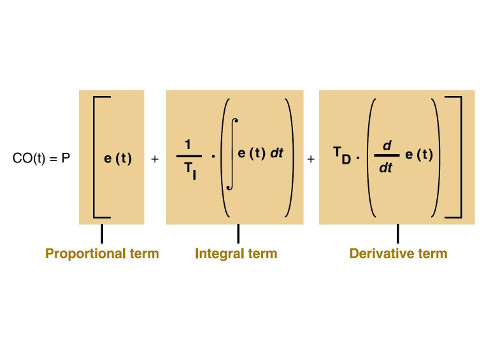
[picture p100: figure]
PID

## PID links

- Link to concept:
- https://www.youtube.com/watch?v=IlSaijwwmpQ
- https://www.youtube.com/watch?v=wkfEZmsQqiA highly recomended
- Unfortunately its not a very easy process.

## Agreement on Operation with Agrics team

## Necessary items

- We’ll control the voltage directly from the analog output of the arduino controller to vary the speed.

## Challenges

- PID code generation and formulation.

## Slide 10

- THE END
