jibebe-jkuat/internship2023/navigation/Navigation team 5.pptx

## Navigation Group

Week FIVE progress

## Members

- List of members;
1. Dennis Bundi.
2. Charles Otieno.
3. Kiragu Maina.
4. Omar Waka.

## Project test robot assembly

- We were able to stabilize the GPS coordinates stated in the code not to offer a variation of location coordinates even inside an obstructed path eg, inside a building.
- We’re still working on combining the raspberry with the existing arduino setup.
- Using both will help save resources on the pi as it’ll be performing the image processing as well.
- The Raspberry Pi has a UART (Universal Asynchronous Receiver/Transmitter) interface that allows it to communicate with other devices using serial communication. The Raspberry Pi's UART pins are to be connected to the Arduino's UART pins using jumper wires.

## Project Progress Software Side

RASPBERRY PI AND CAMERA FOR COMPUTER VISION
We also did research on how we’d go about the obstacle detection and path finding using the pi.
This is a brief outline of how the program should work.
:

## Program operation

- Capture and process images: Use OpenCV to capture images from the camera and process them to detect obstacles or other features that can be used for pathfinding. This can include edge detection, color filtering, or other image processing techniques.
- Determine path: Use the prebuilt pathfinding algorithm (e.g Dijkstra's algorithm) to determine the path from the robot's current location to the desired destination based on the processed images. This can involve calculating distances, angles, and other parameters.
- Control motors: Use the path determined in the previous step to control the motors and move the robot towards the destination while avoiding obstacles. This can involve adjusting the speed and direction of the motors based on the current position and the desired path.

## Acceleration actuator.

- We’ll control the voltage directly from the analog output of the arduino controller to vary the speed.

## Challenges

- Storage for the raspberry pi.
- We need a memory card to help install an operating system to the pi.

## Slide 8

- THE END
