jibebe-jkuat/internship2023/electrical/Electrical team 5.pptx

## WEEK 5 PROGRESS REPORT

EUNICE ORENGE
LABAN MWANGI
VICTOR NGATIA
STEPHEN KINUTHIA

## The week’s TASKS

- DESIGN OF BUCK CONVERTER CIRCUIT
- CONTROLLER PURCHASE RESEARCH

## BUCK CONVERTER DESIGN

12V-5V BUCK CONVERTER CIRCUIT
Circuit Diagram

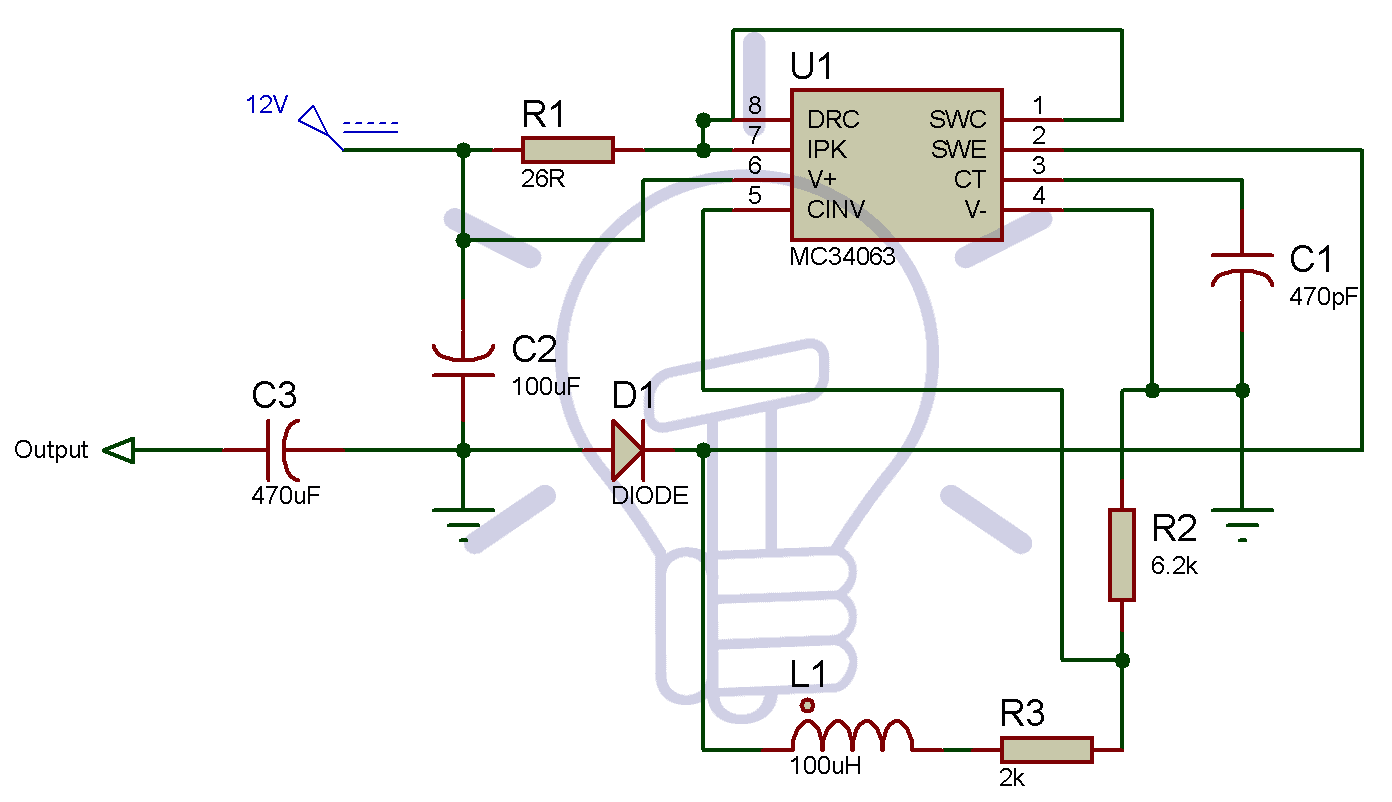
[picture p101: figure]

## Cost of design

- Inverting regulator IC –MC38063-300/=
- Inductor 100µH – 120/=
- Resistors -26-100/=
6.2k-100/=
2k- 100/=
- Capacitors
100µF-100/=
470pF-100/=
470µF-100/=
- Diode 70/=
- Total cost of design 790/=

## BUCK CONVERTER DESIGN

12V-3V BUCK CONVERTER CIRCUIT
Circuit Diagram

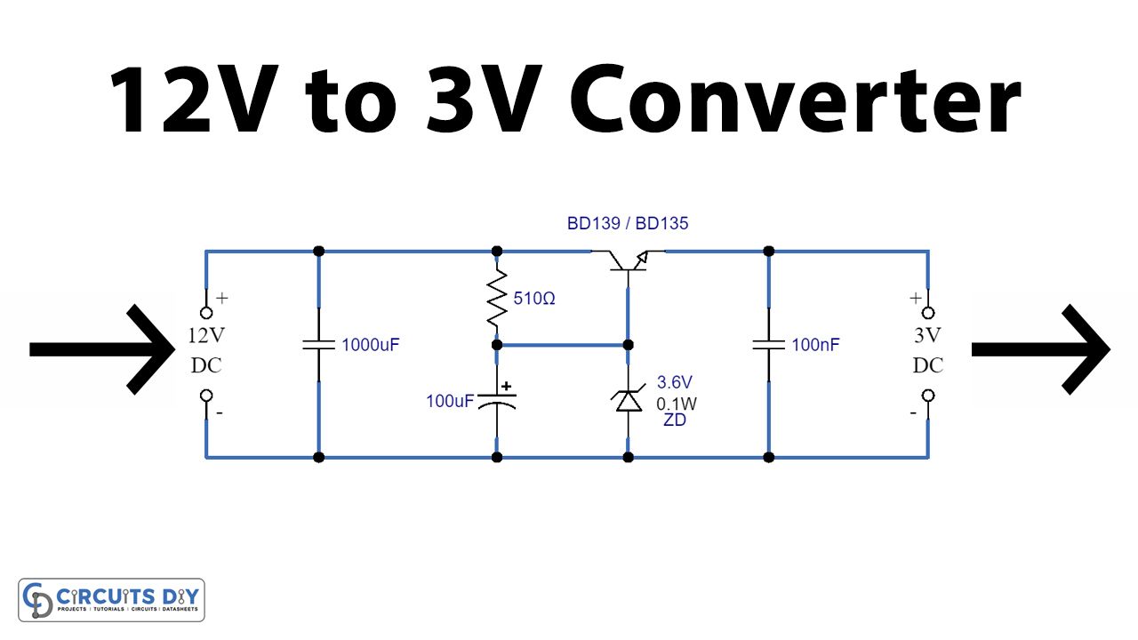
[picture p102: figure]
12V-To-3V-Converter-Using-BD139-NPN-Transistor

## Cost of design

- Capacitors
- -1000µF-100/=
- -100nF- 100/=
- -100µF
- Resistor 510 Ω-100/=
- Zener Diode 3.6V 0.1 W - 120/=
- BD139 NPN transistor -200/=
- Total design cost 620/=

## CIRCUIT DIAGRAM DESIGNED

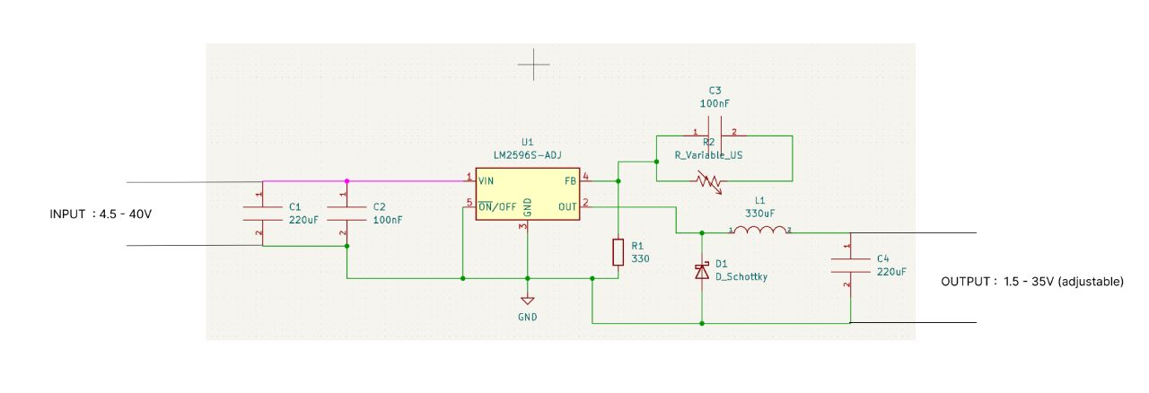
[picture p103: figure]

## COMPARISON

- It is relatively cheaper to buy the converters than it is to fabricate the circuit design, but the team would be up to the challenge of the fabrication.

## Controller purchase

1. KELLY MOTOR CONTROLLER
MODEL NUMBER:KAC96501-8080N
COMPANY NAME: KELLY CONTROLLERS
Price range- 499 – 599 USD
Electric Pedal Price Range : 25-79 USD
Reference : https://kellycontroller.com/shop/kac-8080n/

## CONTROLLER PURCHACE

2. CUTRIS MOTOR CONTROLLER
MODEL NUMBER : CUTRIS 1238E/1239E
COMPANY NAME: CURTIS INSTRUMENTS
PRICE RANGE: 263,000/= Ksh.

## Kelly controller

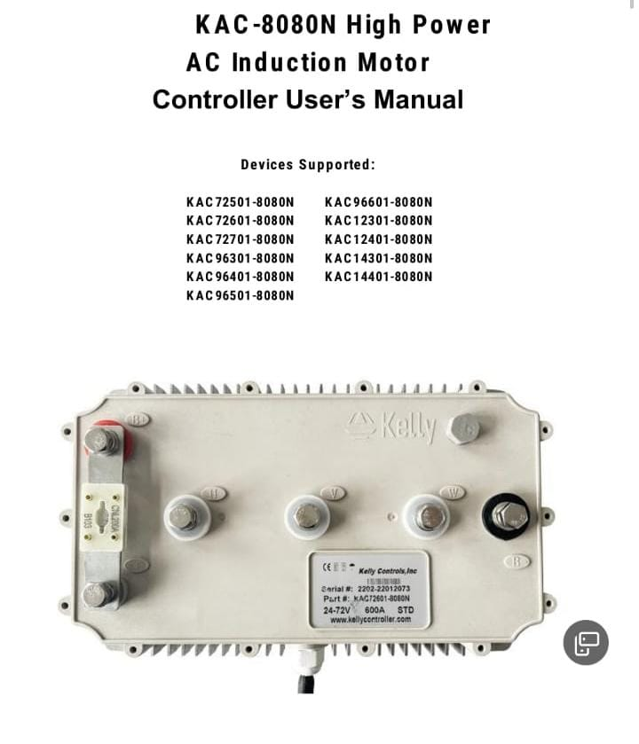
[picture p104: figure]

## Curtis controller

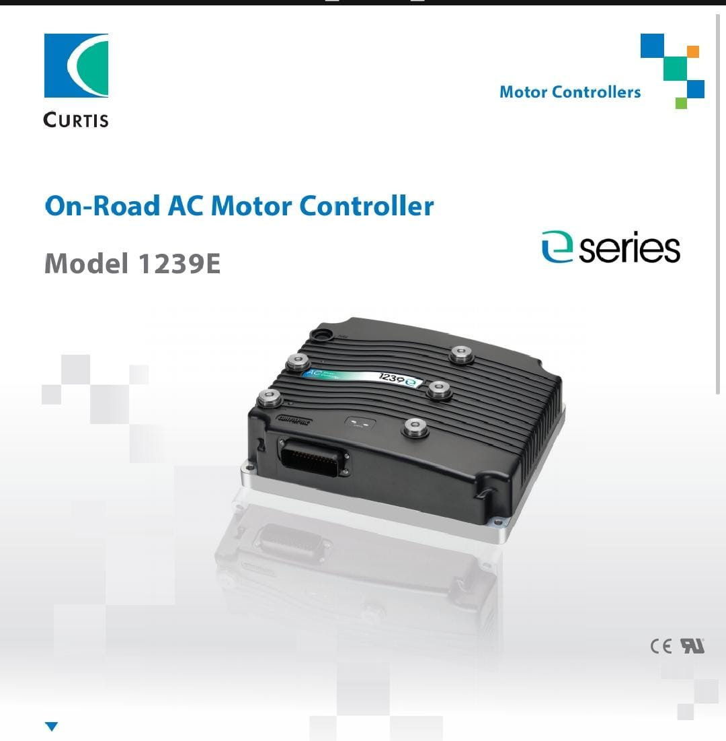
[picture p105: figure]
