jibebe-jkuat/internship2023/navigation/Navigation team 3.pptx

## Navigation Group

Week 3 progress report

## Weekly Work and conclusions.

- Epiphany of workability of the computer vision equipment and availability on the local market
- GPS navigation code was imputed to the robot but there was no ping from the servers.
- Inclusion of the ESP32 Module for motor control with the GPS system.
- Involvement of use of actuators in the accelerator pedals and brake pedals and a one speed gear system for workability.

## Following week Targets.

- Working with the Nakuja project Recovery group for the working of geo-positioning.
- Enabling of the path planning function on the test robot for a set speed limit.

## GPS CODE.

- Tx pins and RX pins brought an issue in configuring.
- Position Fix LED Indicator
- There is an LED on the NEO-6M GPS Module which indicates the status of Position Fix. It’ll blink at various rates depending on what state it’s in
1. No Blinking ==> means It is searching for satellites
2. Blink every 1s – means Position Fix is found
- 3.3V LDO Regulator
- The operating voltage of the NEO-6M chip is from 2.7 to 3.6V. But, the module comes with MIC5205 ultra-low dropout 3V3 regulator from MICREL. The logic pins are also 5-volt tolerant, so we can easily connect it to an Arduino or any 5V logic microcontroller without using any logic level converter.

## Addition Information.

- There was found to be no need of shielding since a power regulator will work for the modules of ESP and GPS.
- Speed will be regulated from the Arduino mega controller.
- Interfacing will done to other modules by the electrical team.
