jibebe-jkuat/internship2023/navigation/Navigation team 2.pptx

## Navigation Group

Week Two progress

## Members update

- We resumed the third week with Eucabeth dropping from the project but got Waka joining us.
- Updated list of members;
1. Dennis Bundi.
2. Charles Otieno.
3. Kiragu Maina.
4. Omar Waka.

## Project test robot assembly

- We successfully assembled the test robot and performed tests on the obstacle avoidance course. Uploading of code. And sensor calibration as well as motor driver speed control.

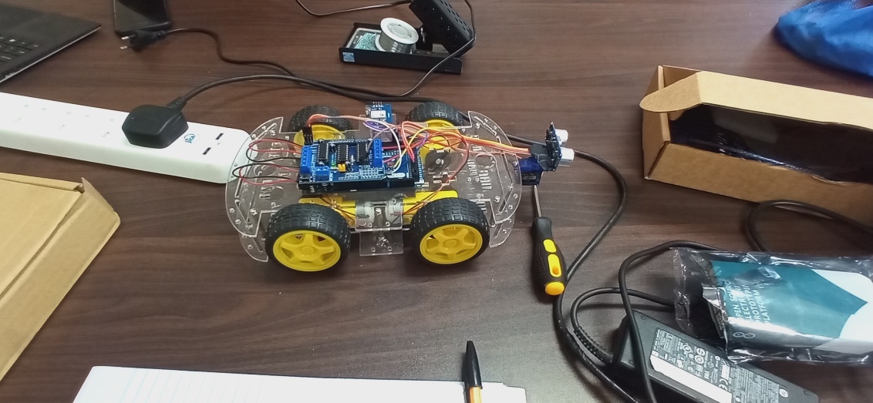
[picture p117: figure]
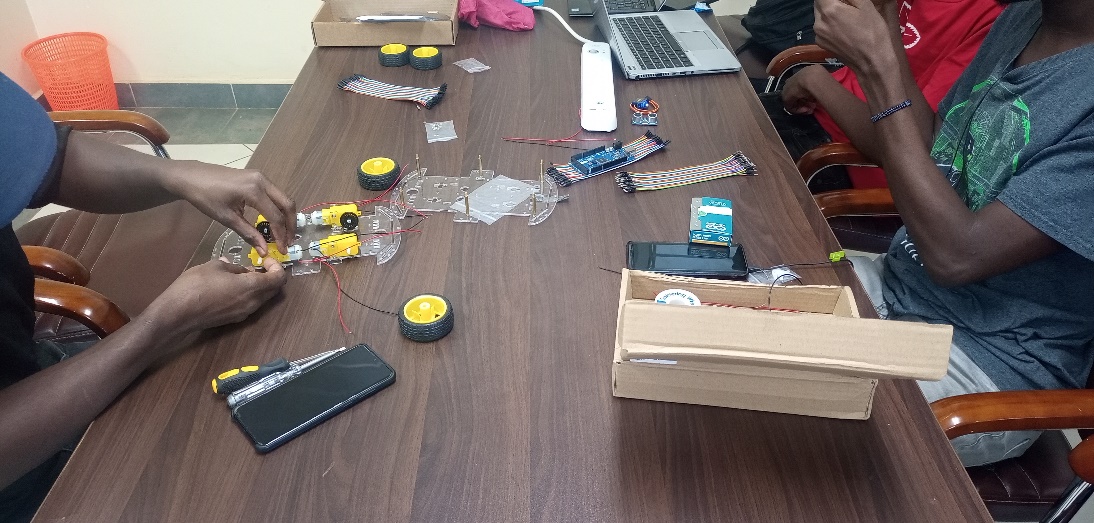
[picture p118: figure]

## Project Progress

- We have successful completed the test robot assembly using obstacle avoidance.
- Next will be moving the test robot to a set GPS geo-position.
- Design of a stand for a computer vision module and camera.
- Design of Acceleration, Braking and Gear shifting actuators.

## GANTT CHART

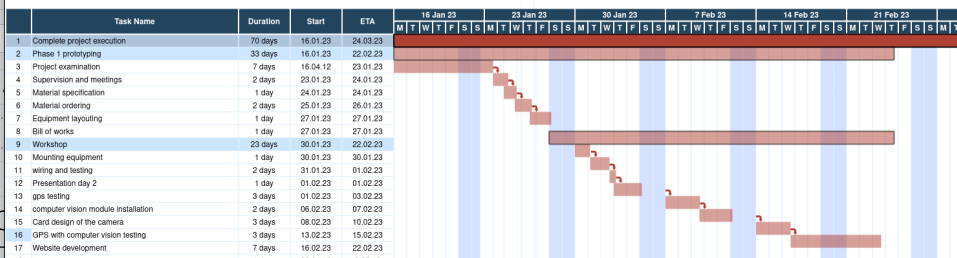
[picture p119: figure]

## Slide 6

- Acceleration, Braking and Gear shifting actuators.

## Challenges

- We could not work with the gps as the magnetometer was missing
- We realised the ultrasonic sensor could not work in the area of application.
- A more appropriate obstacle detection device would be a camera.
- Power. For testing we used a power adapter which limited the robots movement. Rechargeable would be more suited to the task.

## Expected result of the following week.

- We expect to include the computer vision after finishing tests on the GPS path finding. Computer vision is a field of artificial intelligence(AI) enabling computers to derive information from image and video inputs.

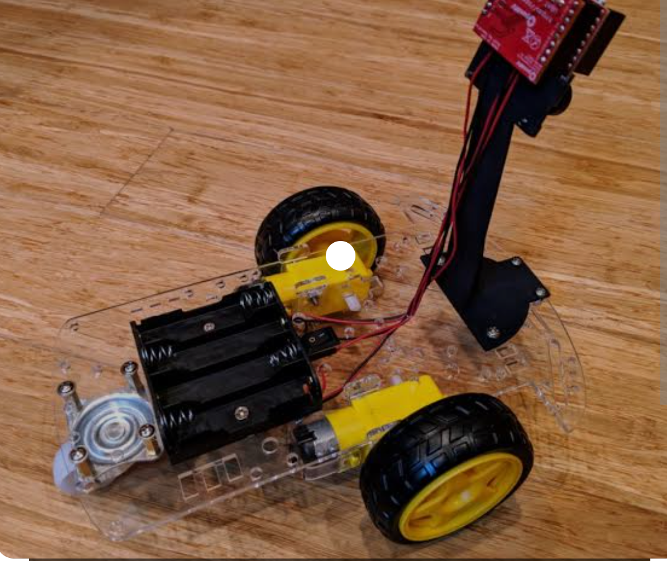
[picture p120: figure]
