jibebe-jkuat/internship2023/electrical/Electrical team 2.pptx

## PROGRESS REPORT

ELECTRICAL TEAM
Eunice oRENGE
Laban Mwangi
VICTOR NGATIA
STEPHEN KINUTHIA

## OBJECTIVES

- Finalize on Testing motor speed
- CAN Integration
- Charging and discharging Battery tests
- Install cable lags and cable connectors

## ARCHIEVEMENTS

- Procured Arduino Mega and MCP
- Tested the Arduino and MCP(synchronizing the Arduino and the MCP)
- Installed cable lags and connectors for safety purposes (Add a breaker to prevent sparking)
- Managed to get the motor running(NOT OPTIMUM)

## Challenges Motor stopped running

FAULTS
- Accelerator fault Alarm
- Under voltage Alarm
- Throttle not accelerating as intended

PROPOSED SOLUTIONS
- Requested for a more detailed manual
- Error detecting device (Mr. Kanja )
- Trying to reconfigure connections

## Challenges

INTERGRATION OF THE MCP AND MOTOR CONTROLLER WAS UNSUCCESSFUL
- Requested for manual
- Research
TESTING THE RATE OF CHARGING
- The batter is fully charged
TESTING BREAKING SYSTEM
- Not yet implemented due to motor not starting
