jibebe-jkuat/internship2023/final_presentation/Final presentation by Jibebe interns 2023 .pdf

# Presentation by interns 2023

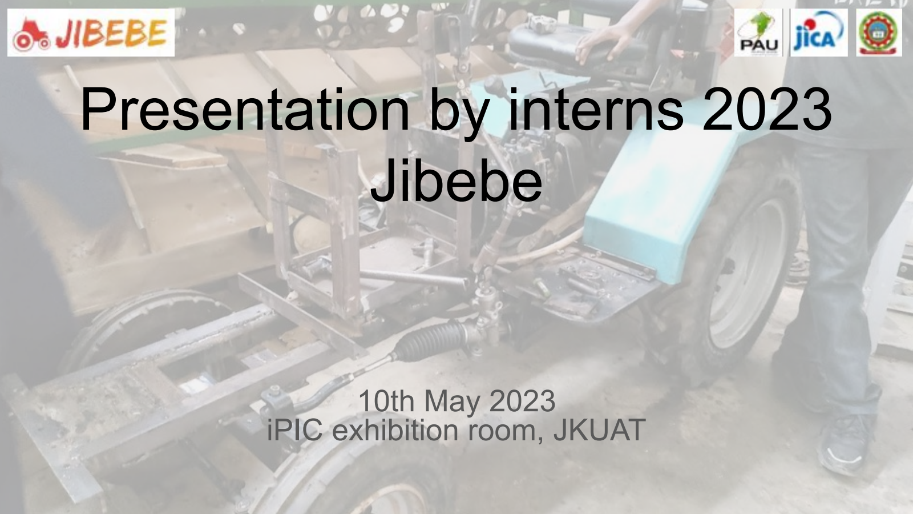
[picture p121: page 1]

# Jibebe

# 10th May 2023 iPIC exhibition room, JKUAT

# Who we are

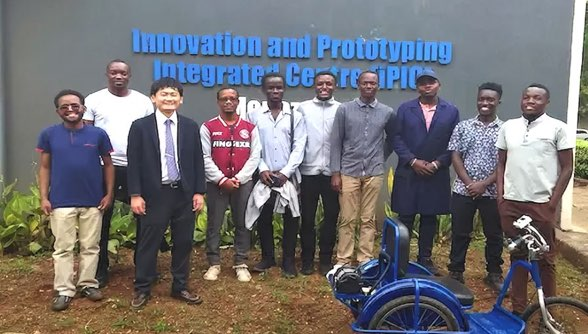
[picture p122: figure]
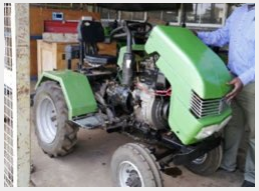
[picture p123: figure]
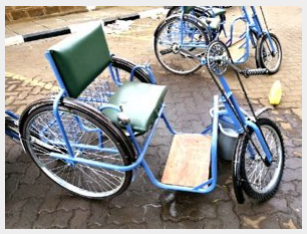
[picture p124: figure]

# About 15 students and supervisors

e-Tricycle | e-Tractor

# Demand for Electric Vehicle (EV) is Rising

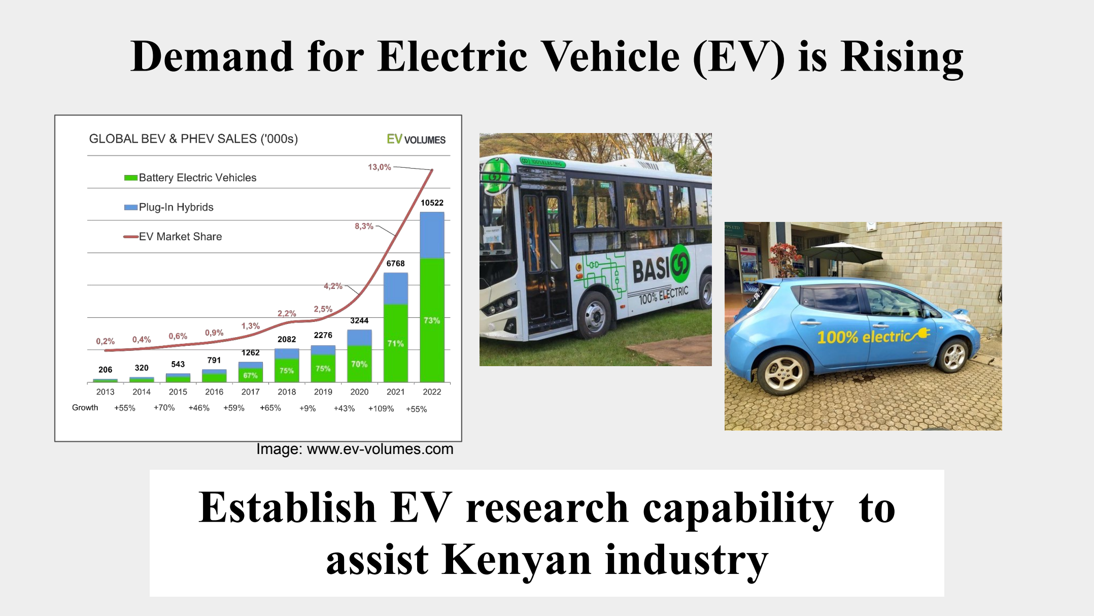
[picture p125: page 3]

# Establish EV research capability to assist Kenyan industry

Image: www.ev-volumes.com

# Collaboration with

## Association for the Physically Disabled of Kenya (APDK)

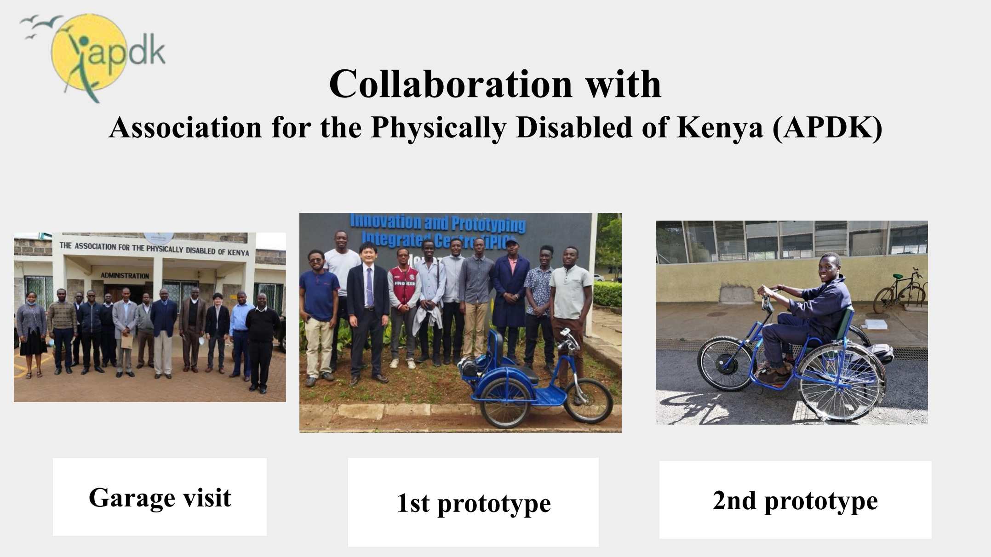
[picture p126: page 4]

Garage visit | 1st prototype | 2nd prototype

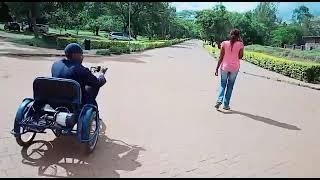
[picture p127: page 5]

# Internship 2023 e-Tractor development

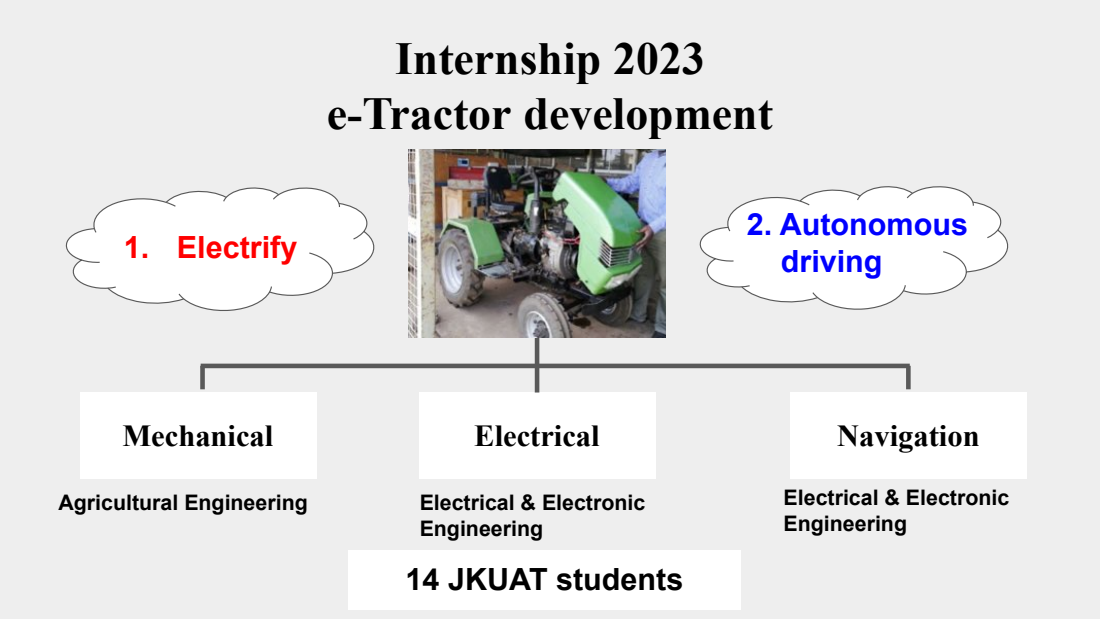
[picture p128: page 6]
14 JKUAT students; Mechanical; Electrical; Navigation; Agricultural Engineering; Electrical & Electronic; Engineering; Electrical & Electronic Engineering; 1. Electrify; 2. Autonomous; driving

# JIBEBE SHUJAA E-TRACTOR

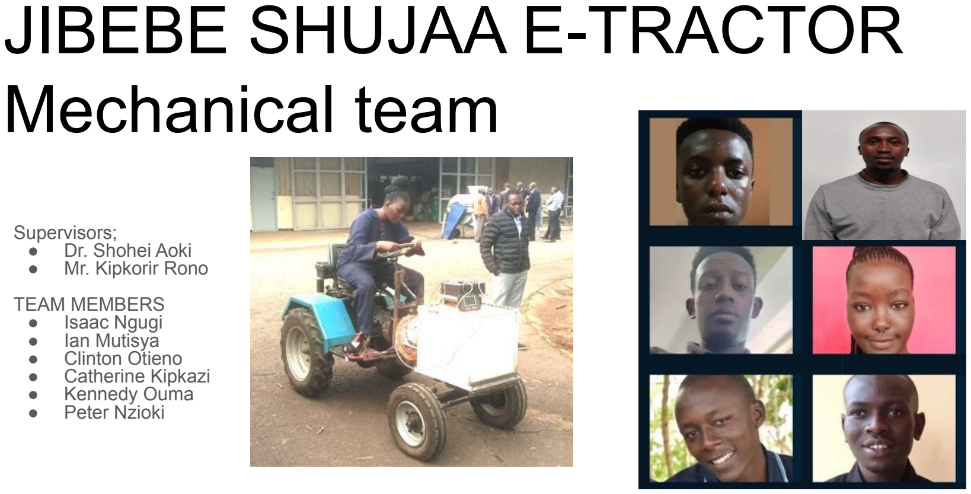
[picture p129: page 7]

# Mechanical team

Supervisors;
- Dr. Shohei Aoki
- Mr. Kipkorir Rono

TEAM MEMBERS
- Isaac Ngugi
- Ian Mutisya
- Clinton Otieno
- Catherine Kipkazi
- Kennedy Ouma
- Peter Nzioki

# Upgrade of Shujaa Tractor

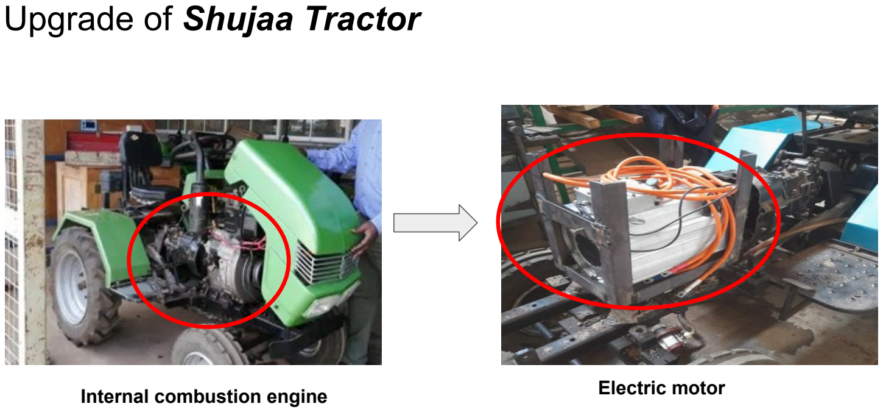
[picture p130: page 8]

Internal combustion engine | Electric motor

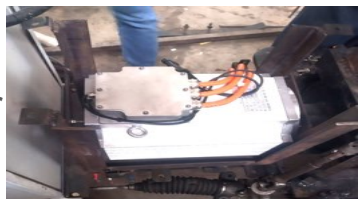
[picture p131: figure]

## Objective: Electrification of Shujaa tractor

## Specific objectives

## 1. Disassembly of IC engine and its components 2. Design of motor and battery mountings 3. Design of a new steering system 4. Adjustments to increase stability 5. Fabrication and assembly of the EV

## TIMELINE

## - WEEK 1-3- Design - WEEK 2-11- Fabrication work - WEEK 13-14- Testing

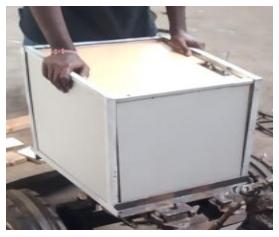
[picture p132: figure]

Motor | Battery box

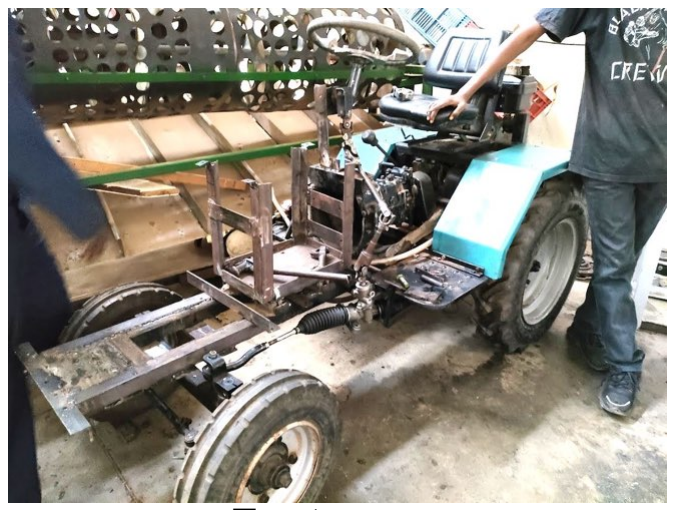
[picture p133: figure]

Tractor

## - POWERTRAIN - Retained to shorten development time

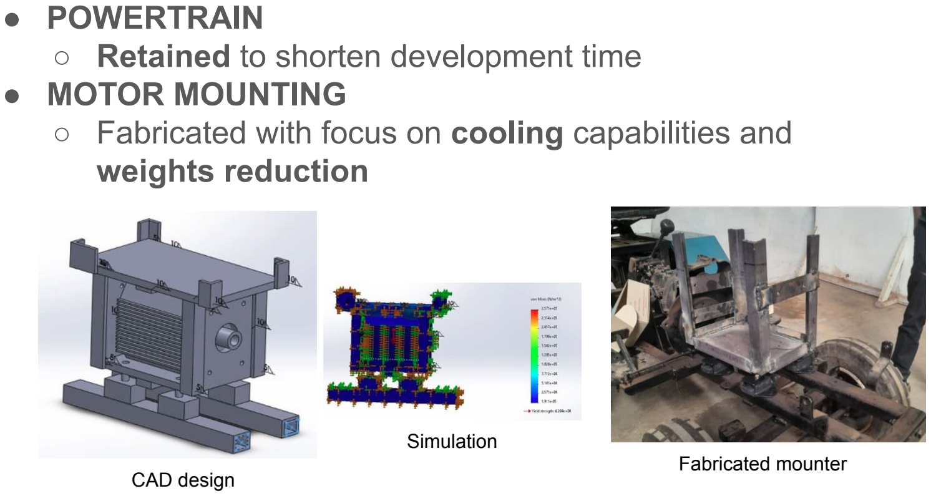
[picture p134: page 10]

## - MOTOR MOUNTING - Fabricated with focus on cooling capabilities and weights reduction

Simulation

CAD design

Fabricated mounter

# Fabricated and upgraded components

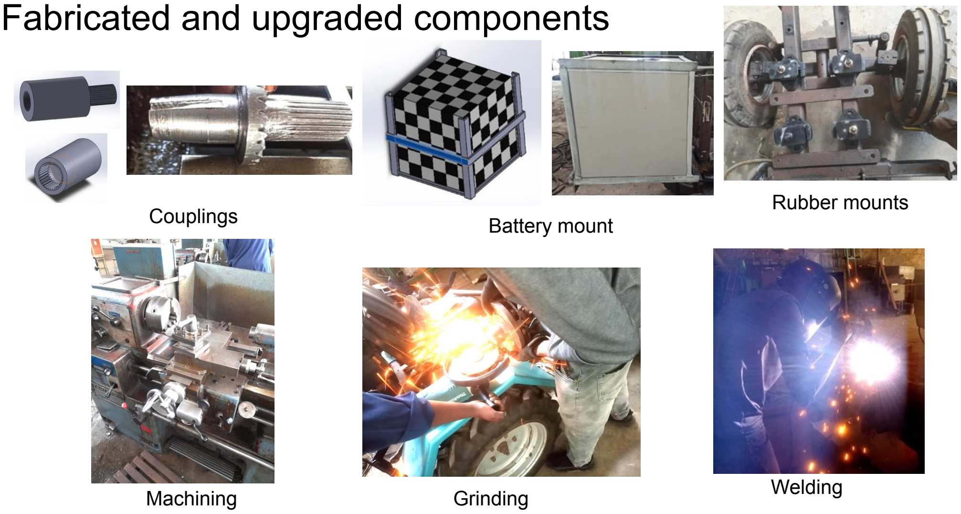
[picture p135: page 11]

Rubber mounts Couplings | Battery mount
Machining | Grinding | Welding

# Heat treatment of the mechanical parts

## - Coupling for power transmission - Mild steel used - Heat treated to enhance the strength with assistance from

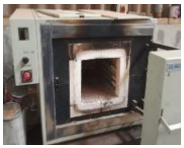
[picture p136: figure]

## Mr. Mwai

Furnace | Part (red-hot)

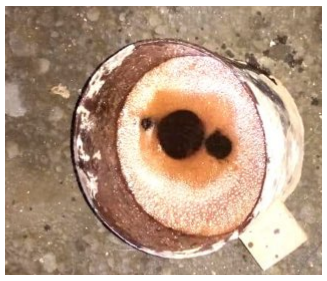
[picture p137: figure]
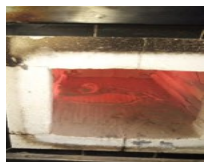
[picture p138: figure]

MILD STEEL HARDENING
PROCESS

# BATTERY MOUNTING

## - Integrated into the chassis to reduce weight and complexity - Chassis was extended to improve weight distribution

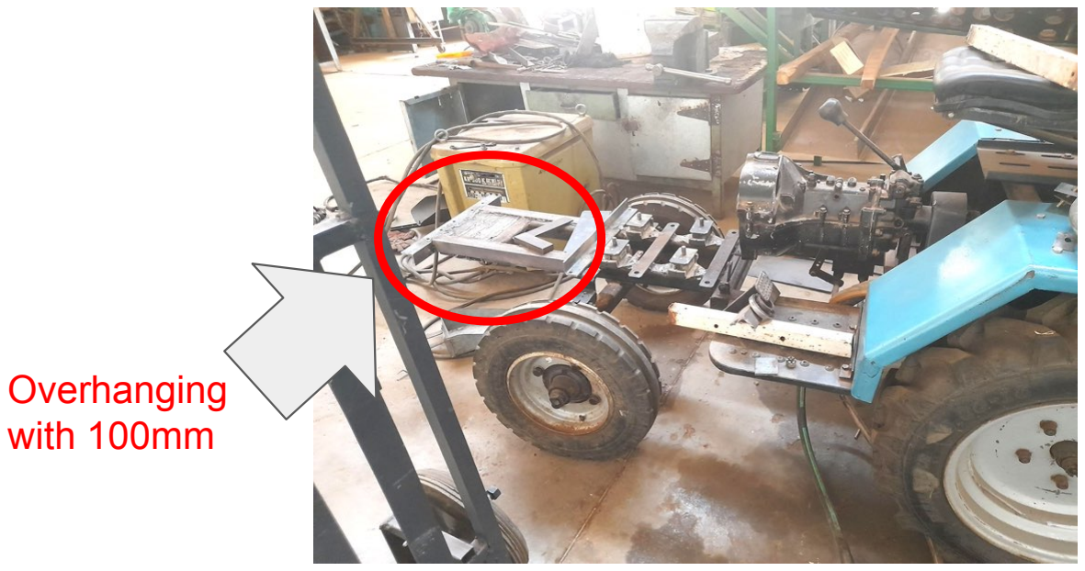
[picture p139: figure]
Overhanging with 100mm

# DESIGN OF A NEW STEERING SYSTEM

## Steering angle using the

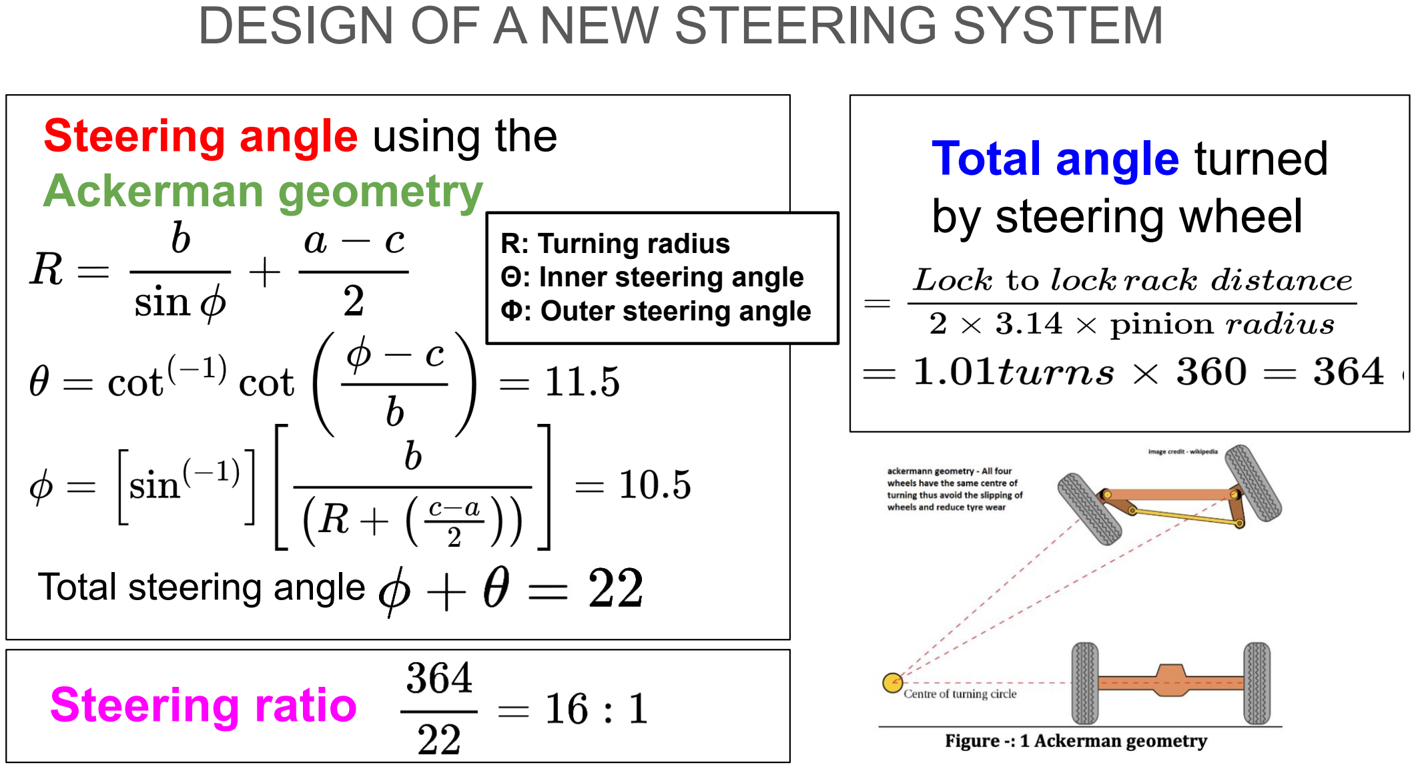
[picture p140: page 14]

## Total steering angle

Ackerman geometry | Total angle turned by steering wheel

# Steering ratio

R: Turning radius
Θ: Inner steering angle
Φ: Outer steering angle

# Fabrication of new steering system

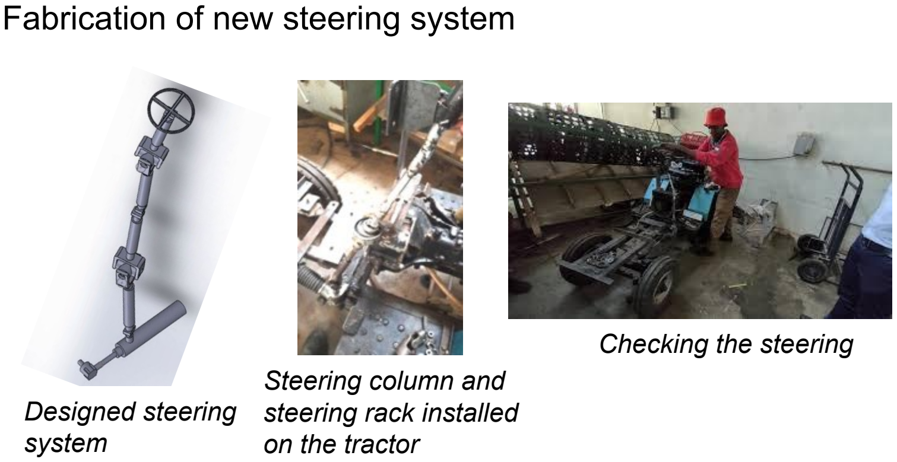
[picture p141: page 15]

## Steering column and steering rack installed on the tractor

## Designed steering system

## Checking the steering

# ADJUSTMENTS ON STABILITY

## Wheelbase was increased by 200mm

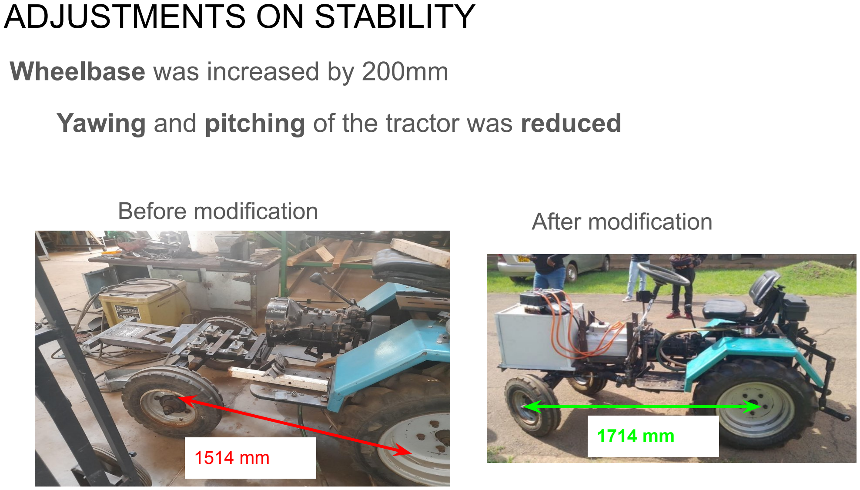
[picture p142: page 16]

## Yawing and pitching of the tractor was reduced

Before modification | After modification

1514 mm

1714 mm

# Tractor demo

## Tractor on road during testing

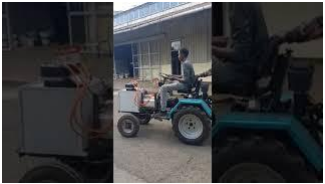
[picture p143: figure]

# Challenges

## - Inexperience in the field of advanced testing and simulation - Lack of technical knowledge in some research areas

# Remaining issues

## In the next prototype, there are a few changes to be made to make it ready for

production. These are such as;

## - Incorporation of a suspension to improve ride quality - Implementation of traction control to improve stability - Upgrading braking from 2 wheel drum brake to hybrid disc and drum

brake.

## - Incorporation of power steering - Incorporation of all wheel drive with torque vectoring

# CLOSING REMARKS

## As the mechanical team, we would like to appreciate the support we have received from our supervisors with special focus on Dr. Shohei Aoki. The encouragement and willingness to assist has propelled us to push the development of the Shujaa E-tractor. We would like to challenge the next

mechanical team to push harder and optimize the Shujaa tractor further.

## THANK YOU

## どうもありがとうございます

# Electrical Team -

# Jibebe E-tractor project

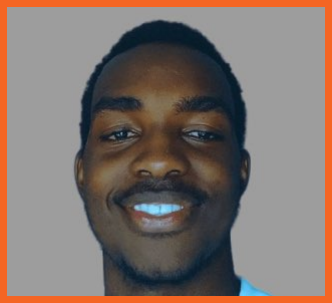
[picture p144: figure]
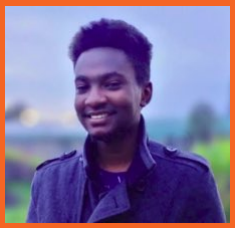
[picture p145: figure]
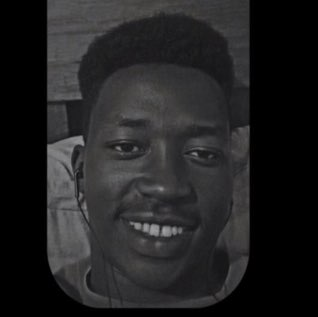
[picture p146: figure]
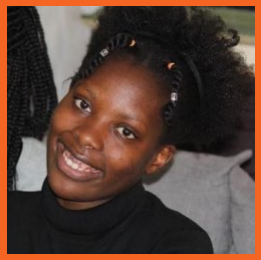
[picture p147: figure]

Stephen Kinuthia | Laban Mwangi | Victor Ngatia | Eunice Orenge

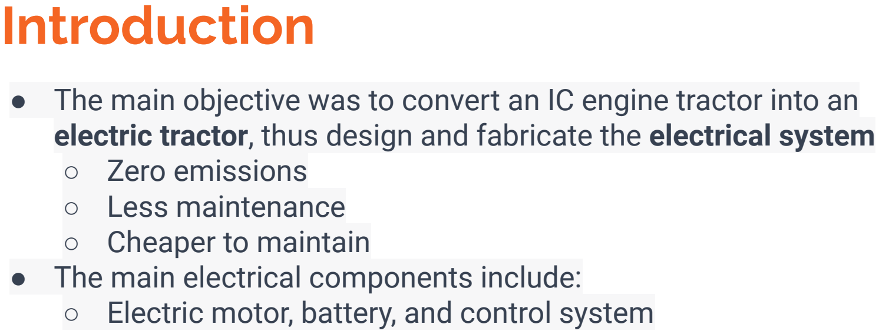
[picture p148: figure]
Introduction; ○ Zero emissions ○ Less maintenance ○ Cheaper to maintain

## - The main objective was to convert an IC engine tractor into an electric tractor, thus design and fabricate the electrical system

## - The main electrical components include: - Electric motor, battery, and control system

# Objectives

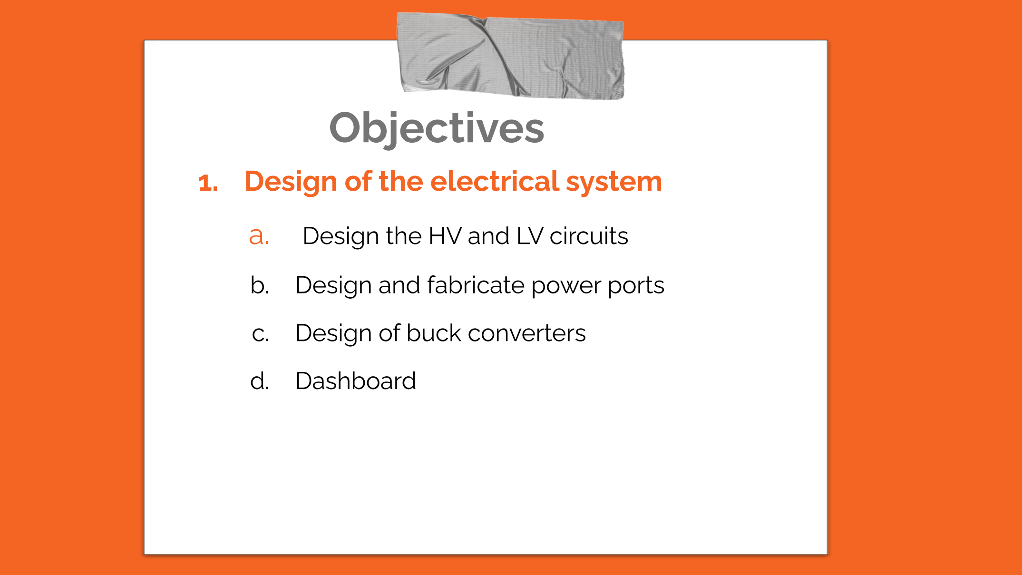
[picture p149: page 23]

# 1. Design of the electrical system

## a. Design the HV and LV circuits

## b. Design and fabricate power ports

## c. Design of buck converters

## d. Dashboard

# Objectives

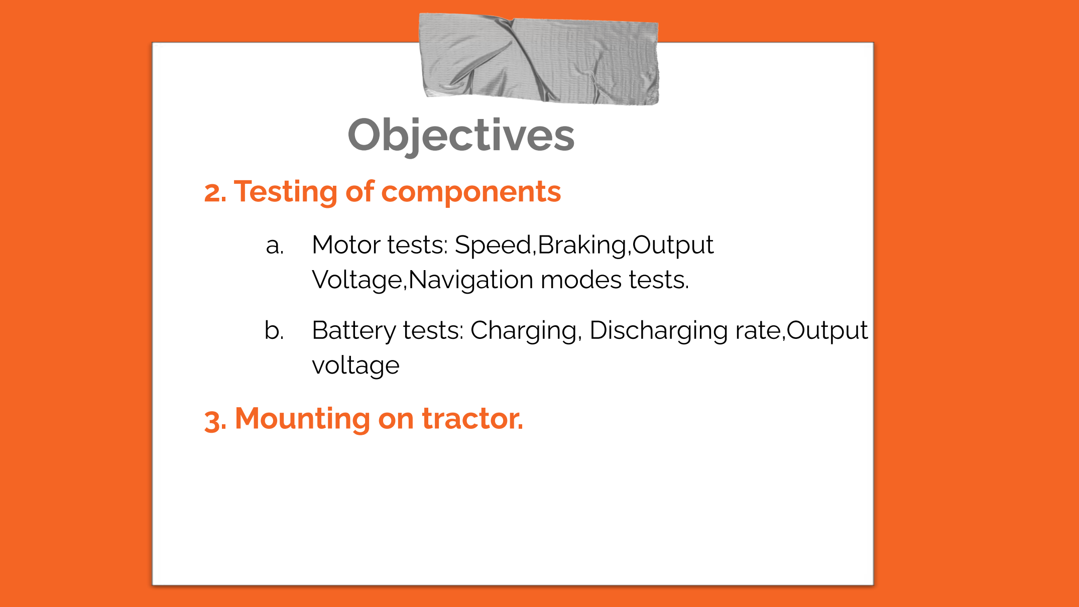
[picture p150: page 24]

# 2. Testing of components

## a. Motor tests: Speed,Braking,Output

Voltage,Navigation modes tests.

## b. Battery tests: Charging, Discharging rate,Output voltage

3. Mounting on tractor.

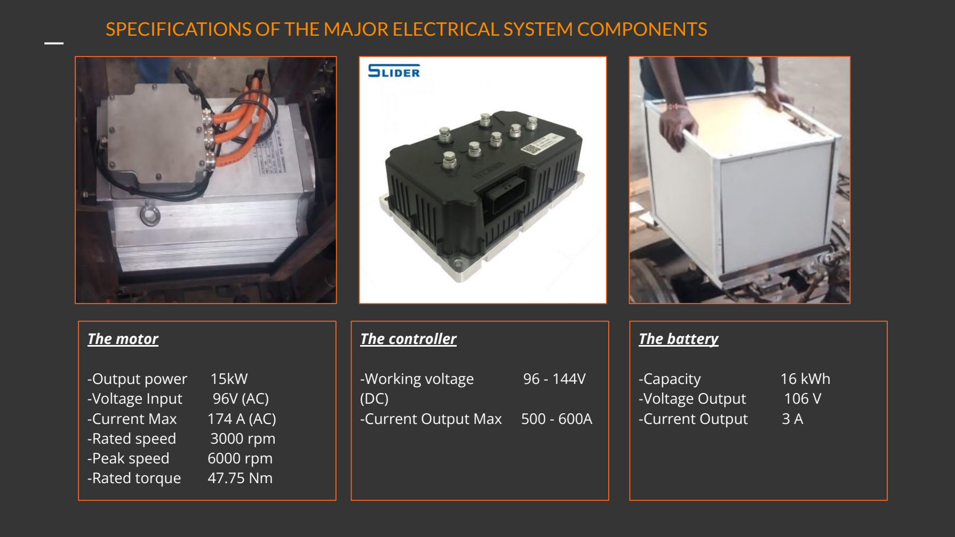
[picture p151: page 25]

The motor

-Output power 15kW
-Voltage Input | 96V (AC)
-Current Max | 174 A (AC)
-Rated speed | 3000 rpm
-Peak speed | 6000 rpm
-Rated torque | 47.75 Nm

The battery

-Capacity | 16 kWh
-Voltage Output | 106 V
-Current Output | 3 A

The controller

-Working voltage 96 - 144V (DC)
-Current Output Max 500 - 600A

SPECIFICATIONS OF THE MAJOR ELECTRICAL SYSTEM COMPONENTS

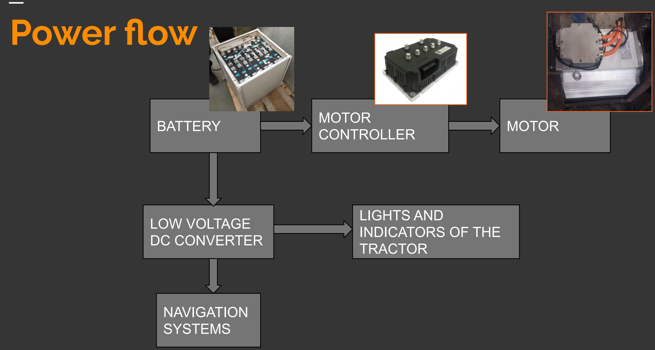
[picture p152: figure]
Power flow; BATTERY; MOTOR; CONTROLLER; LOW VOLTAGE DC CONVERTER; NAVIGATION SYSTEMS; LIGHTS AND INDICATORS OF THE TRACTOR
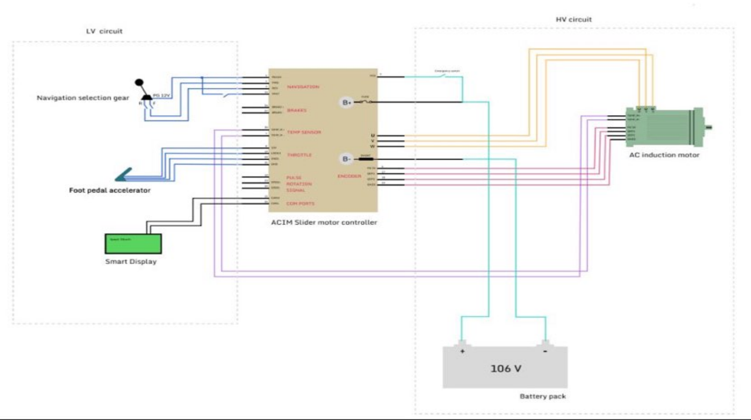
[picture p153: page 27]

# Design of Buck Converter

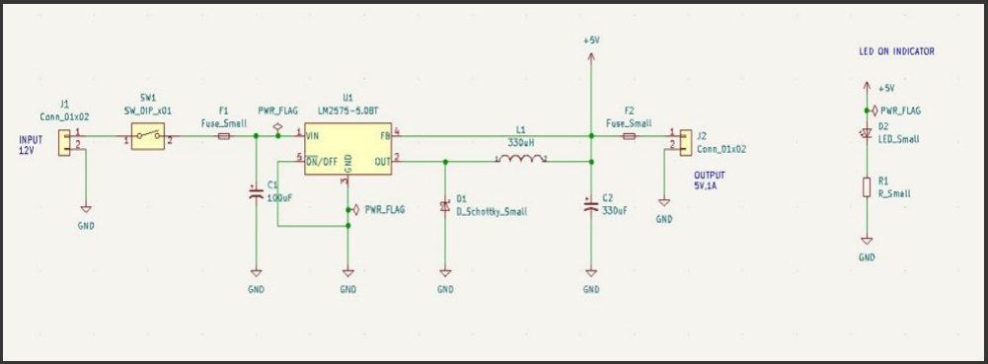
[picture p154: figure]

### Schematic diagram of the converter

# PCB Design of Buck Converter

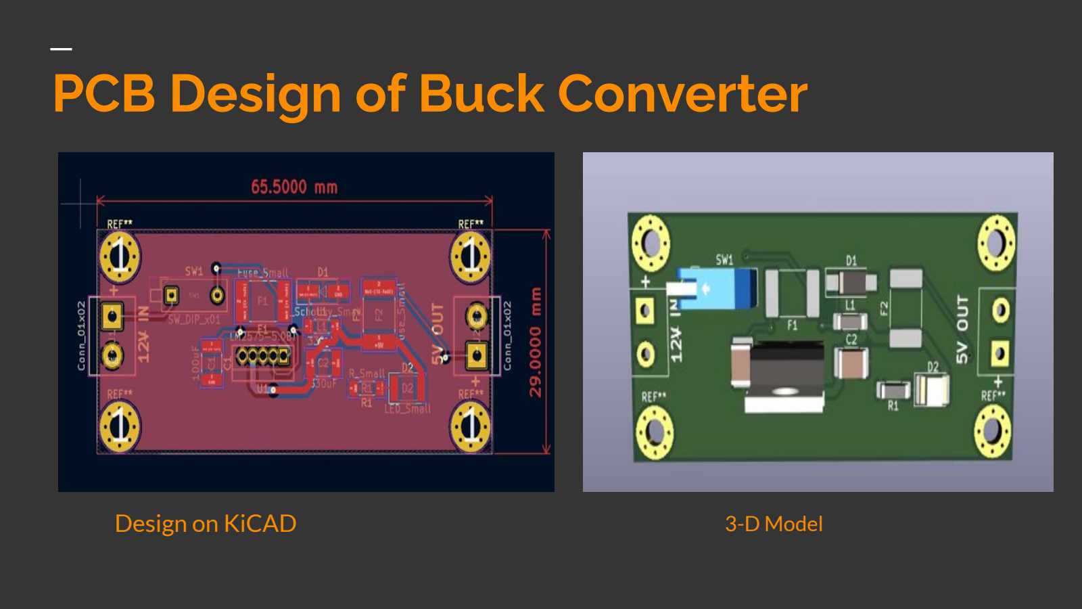
[picture p155: page 29]

Design on KiCAD | 3-D Model

# PCB Fabrication of Buck Converter

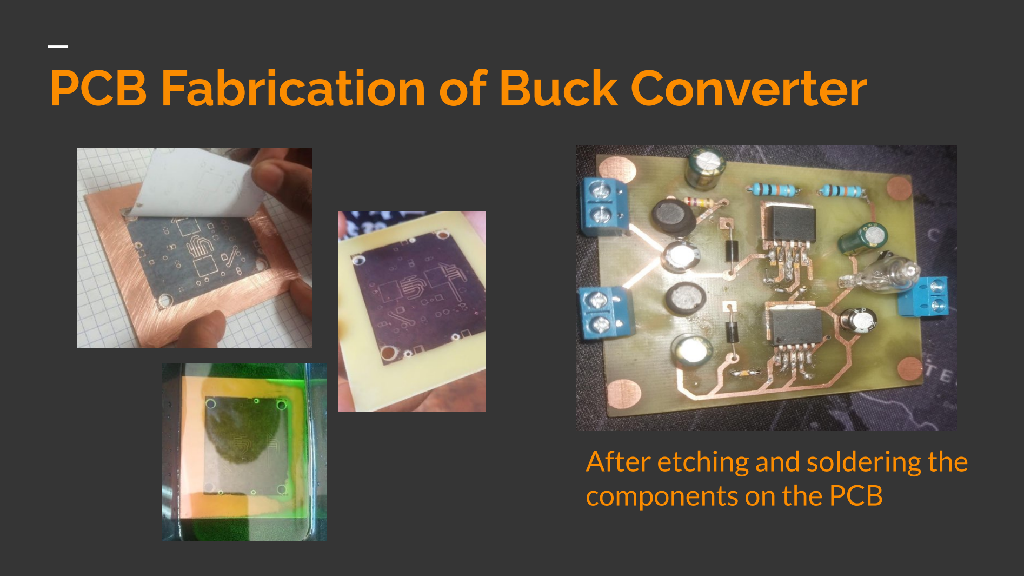
[picture p156: page 30]

## After etching and soldering the components on the PCB

# Outcome of Tests

# Motor Tests - Speed Test : 3000 rpm

- Brake Test : Manually done on tractor.

# - Controller output voltage : 60V Line to Line - Navigation Modes i.e Reverse, Forward and Half Rev work perfectly Battery Tests - Output Voltage: 106V DC

# Mounting components on the tractor

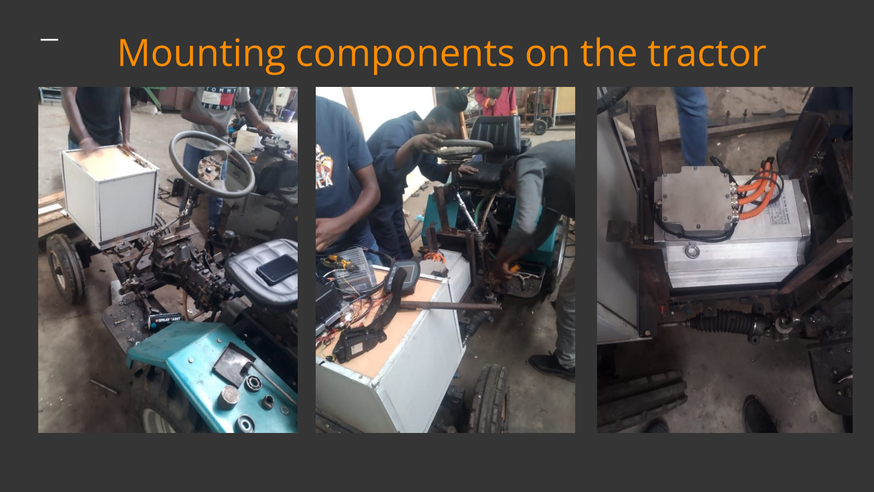
[picture p157: page 32]
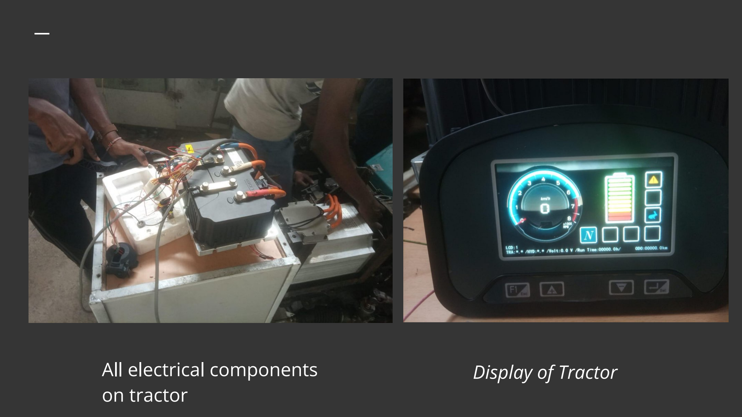
[picture p158: page 33]

All electrical components | Display of Tractor

# on tractor

# Challenges and remaining tasks

Challenges - The first controller were disabled after experiencing an error - Under voltage and acceleration error - A lot of time was spent in trouble shooting and purchasing another - The delay was felt across all the teams Remaining Tasks 1. Connection of the DC-DC converters 2. Charging and Discharging Tests

# Skills learned and developed

# - PCB Designing - Troubleshooting Electrical components - PCB etching - Soldering - Presentation skills ; shaped by our weekly reporting sessions

Navigation Group.

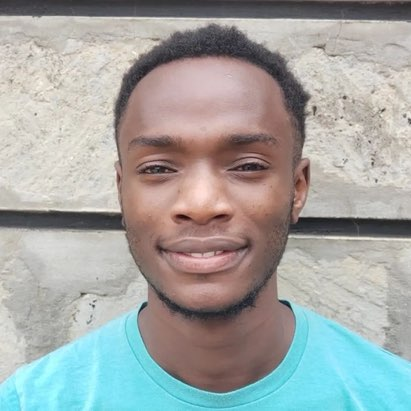
[picture p159: figure]
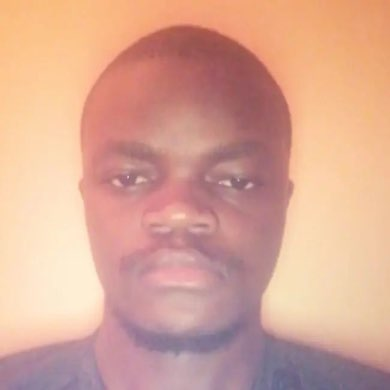
[picture p160: figure]
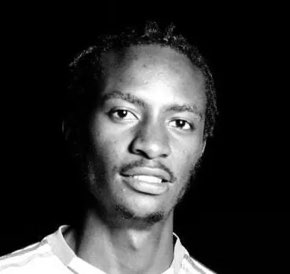
[picture p161: figure]
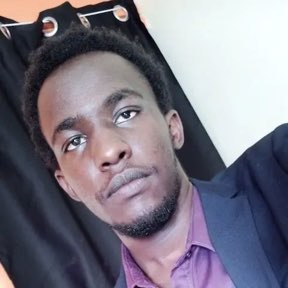
[picture p162: figure]

DENNIS BUNDI | OMAR WAKA | KIRAGU MAINA | CHARLES OTIENO

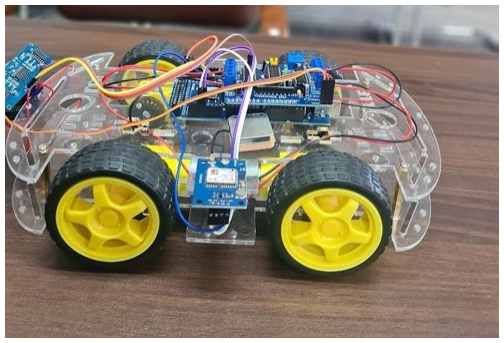
[picture p163: figure]

- Test robot was developed to test the following functions:
- Obstacle Avoidance
- Navigation system using GPS
- Automation (unmanned system with functional sensors).
- Robot was actually developed in a period of three weeks

# Objective 1: Construction of a test robot

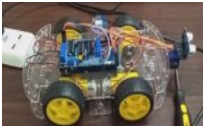
[picture p164: figure]

## Test robot assembly

- Assembled the test robot
- Performed tests on the obstacle avoidance course
- Uploading of code
- Sensor calibration
- Motor driver speed control

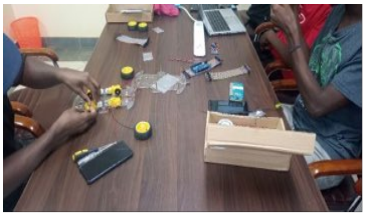
[picture p165: figure]

Research on available GPS modules

- First module
- Neo 6m GPS module: Failure
- Instability at first and later on total malfunctioning
- Second module
- Neo 7m GPS module: Success
- Needed some more calibration using the haversine formula
- use the radius of the earth as the focal point
- target point to the starting locations

# Objectives 2: GPS navigation

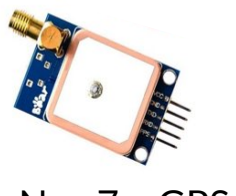
[picture p166: figure]

Neo 7m GPS

HAVERSINE formula of the GPS module.

## - Haversine formula is used to calculate the position - Longitude and latitude in meters

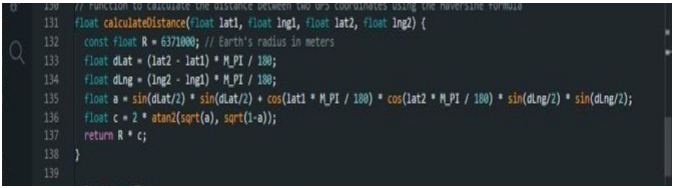
[picture p167: figure]

- Subtracting the two locations to achieve the distance to set TARGET
- Calculate both the distance and cardinal orientation from the current position to the set TARGET location

## Code Explanation

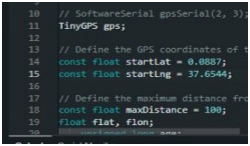
[picture p168: figure]

## Code Explanation

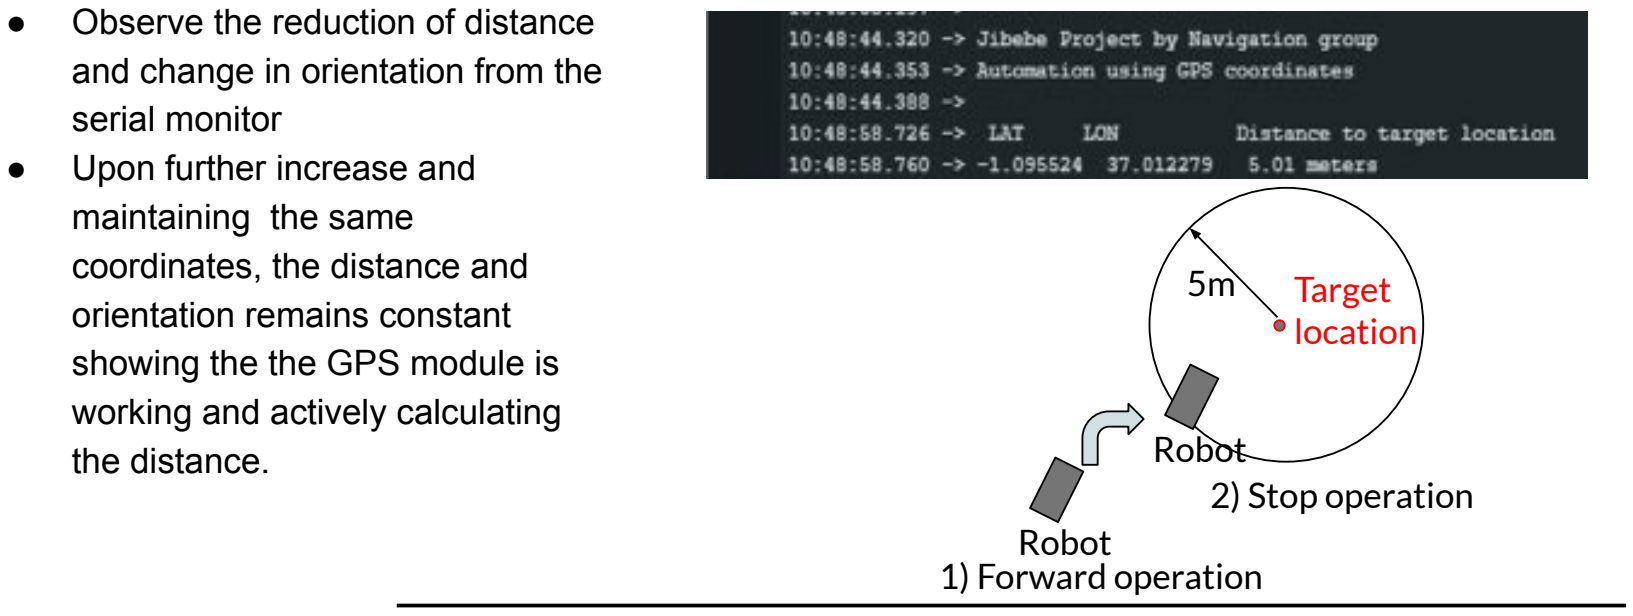
[picture p169: figure]
● Observe the reduction of distance; and change in orientation from the; serial monitor ● Upon further increase and; maintaining the same; coordinates, the distance and; orientation remains constant showing the the GPS module is; working and actively calculating the distance.; Target location; Robot; 1) Forward operation; 2) Stop operation

# Tractor path generator

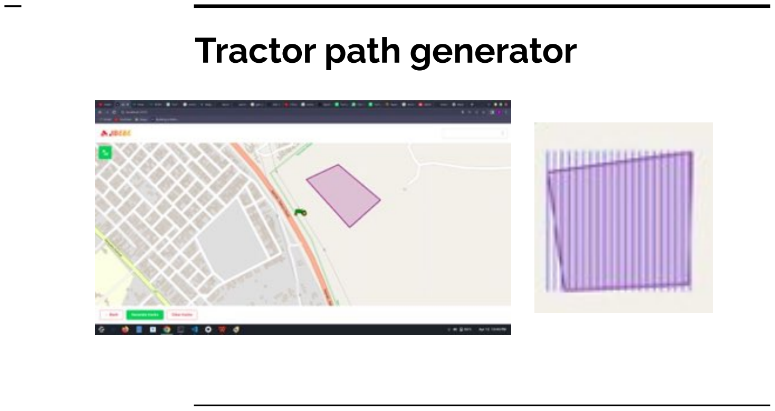
[picture p170: page 43]

From the navigation group, we have made successful steps from our group objectives and some objectives are yet to be fulfilled.

- Achievements.
1. Assembly of test robot.
2. Obstacle avoidance sensor implementation.
3. GPS module testing.
4. Path generating application.

CONCLUSIONS.

From the navigation group, we have made successful steps from our group objectives and some objectives are yet to be fulfilled.

- Future endeavours.
1. Application on the tractor.
2. Development of a website.

CONCLUSIONS.

# Way forward

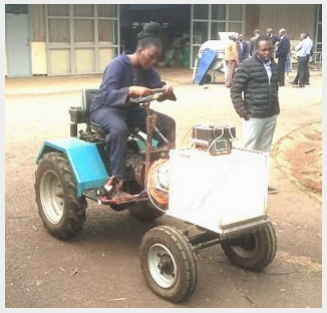
[picture p171: figure]

## Tractor project seek industrial partner

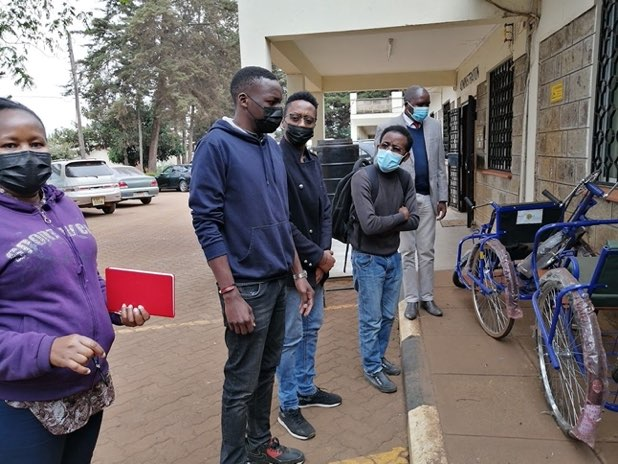
[picture p172: figure]

## Final year students work with APDK to commercialize the tricycle

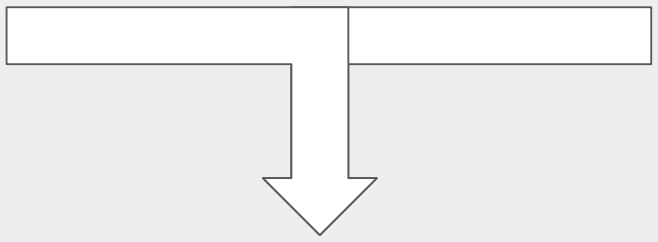
[picture p173: figure]

## More JKUAT researchers are sought to establish EV research group

# Follow us

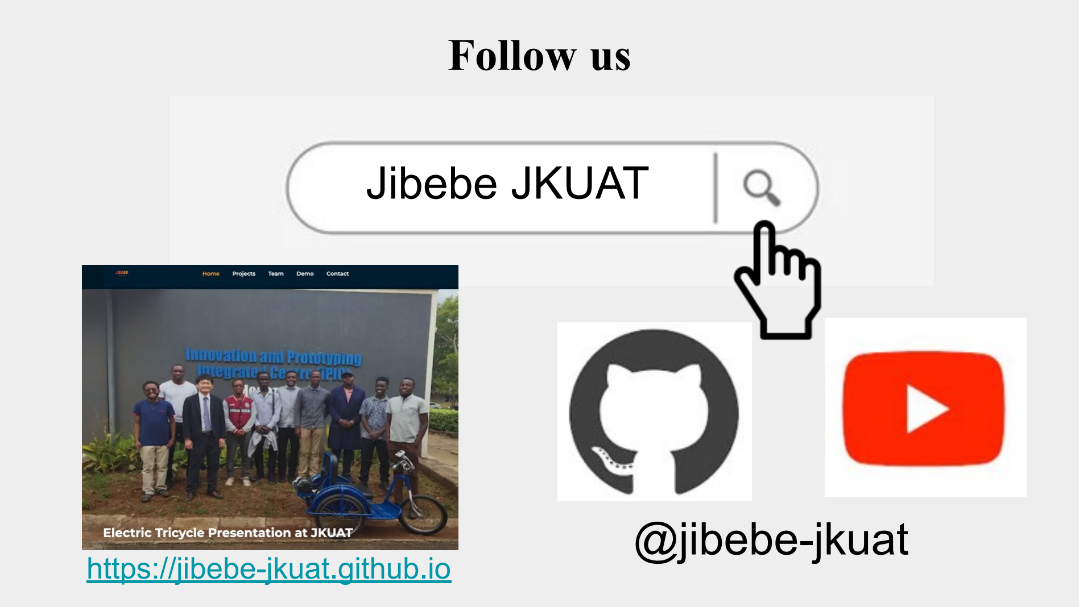
[picture p174: page 47]

# @jibebe-jkuat

# Jibebe JKUAT

## https://jibebe-jkuat.github.io
