jibebe-jkuat/internship2023/mechanical/Mechanical Gantt Chart.xlsx

Sheet: Simple Gantt chart
Task | Start on day | Duration
test and disassembly | 2023-01-16 | 2023-01-20
Motor and fan mount design | 2023-01-23 | 2023-01-27
motor and fan mount fabrication | 2023-01-30 | 2023-02-10
design of flywheel coupling | 2023-02-09 | 2023-02-13
battery mount design | 2023-02-13 | 2023-02-15
battery mount fabrication | 2023-02-15 | 2023-02-17
fly wheel fabrication | 2023-02-20 | 2023-02-22
mounting on tractor | 2023-02-23 | 2023-02-24
no load test | 2023-02-25 | 2023-02-27
design of pump coupling | 2023-02-28 | 2023-03-02
fabrication of pump coupling | 2023-03-03 | 2023-03-07
fabrication of pump mount | 2023-03-10 | 2023-03-13
farm test | 2023-03-13 | 2023-03-14
Task | Start date | End date
test and disassembly | 0 | 4
Motor and fan mount design | 7 | 11
motor and fan mount fabrication | 14 | 25
design of flywheel coupling | 24 | 28
battery mount design | 28 | 30
battery mount fabrication | 30 | 32
fly wheel fabrication | 35 | 37
mounting on tractor | 38 | 39
no load test | 40 | 42
design of pump coupling | 43 | 45
fabrication of pump coupling | 46 | 50
fabrication of pump mount | 53 | 56
farm test | 56 | 57

Sheet: Gantt chart with dependencies
Task | Dependency | Duration (Days) | Team | Owner | Task Start Date | Task End Date | Dep Start Date | Dep End Date | 1 | 2 | 3 | 4 | 5 | 6 | 7 | 8 | 9 | 10 | 11 | 12 | 13 | 14 | 15 | 16 | 17 | 18 | 19 | 20 | 21 | 22 | 23 | 24 | 25 | 26 | 27 | 28 | 29 | 30
Task 1 |  | 5 |  |  | 2021-08-05 | 2021-08-10 | N/A | N/A |  |  |  |  | x | x | x | x | x | x
Task 2 | Task 1 | 2 |  |  | 2021-08-10 | 2021-08-12 | 2021-08-05 | 2021-08-10 |  |  |  |  |  |  |  |  |  | x | x | x
Task 3 | Task 2 | 3 |  |  | 2021-08-12 | 2021-08-15 | 2021-08-10 | 2021-08-12 |  |  |  |  |  |  |  |  |  |  |  | x | x | x | x
Task 4 | Task 3 | 4 |  |  | 2021-08-15 | 2021-08-19 | 2021-08-12 | 2021-08-15 |  |  |  |  |  |  |  |  |  |  |  |  |  |  | x | x | x | x | x
Task 5 | Task 4 | 4 |  |  | 2021-08-19 | 2021-08-23 | 2021-08-15 | 2021-08-19 |  |  |  |  |  |  |  |  |  |  |  |  |  |  |  |  |  |  | x | x | x | x | x
Task 6 | Task 5 | 1 |  |  | 2021-08-23 | 2021-08-24 | 2021-08-19 | 2021-08-23 |  |  |  |  |  |  |  |  |  |  |  |  |  |  |  |  |  |  |  |  |  |  | x | x
Task 7 | Task 6 | 1 |  |  | 2021-08-24 | 2021-08-25 | 2021-08-23 | 2021-08-24 |  |  |  |  |  |  |  |  |  |  |  |  |  |  |  |  |  |  |  |  |  |  |  | x | x
Task 8 | Task 7 | 2 |  |  | 2021-08-25 | 2021-08-27 | 2021-08-24 | 2021-08-25 |  |  |  |  |  |  |  |  |  |  |  |  |  |  |  |  |  |  |  |  |  |  |  |  | x | x | x
Task 9 | Task 8 | 1 |  |  | 2021-08-27 | 2021-08-28 | 2021-08-25 | 2021-08-27 |  |  |  |  |  |  |  |  |  |  |  |  |  |  |  |  |  |  |  |  |  |  |  |  |  |  | x | x
Task 10 | Task 9 | 2 |  |  | 2021-08-28 | 2021-08-30 | 2021-08-27 | 2021-08-28 |  |  |  |  |  |  |  |  |  |  |  |  |  |  |  |  |  |  |  |  |  |  |  |  |  |  |  | x | x | x
Task 11 | Task 10 | 1 |  |  | 2021-08-30 | 2021-08-31 | 2021-08-28 | 2021-08-30 |  |  |  |  |  |  |  |  |  |  |  |  |  |  |  |  |  |  |  |  |  |  |  |  |  |  |  |  |  | x
