jibebe-jkuat/internship2023/navigation/Navigation team 1.pptx

## Navigation group

Progress report –week one.

## Overview of previous group work.

- From the depository of the GitHub account- https:// (https://github.com/jibebe-jkuat/internship2022)github.com/jibebe-jkuat/internship2022 . we found the progress report and word documentations that explained their successes and failures of the project.
- From these directives we analyzed the codes and the pictures to establish our planned coursework for the period of the attachment.

## Concerns and issues arisen.

i. Usability of previously constructed test robot and code.
ii. Approval of proposed timeline and events scheduled.
iii. Integration of software and used parts with the electrical team.

## Things to do

1. Construction of a robot i.e to showcase functionalities that include:
- Obstacle Avoidance.
- Navigation system using GPS
- AUTOMATION(UNMANNED SYSTEM WITH FUNCTIONAL SENSORS).
            - [ 2 WEEKS ]

## THINGS TO DO.

2. TESTING AND RECALIBRATION OF THE ROBOT SYSTEMS USING INTERFACED CONTROL SYSTEMS FROM THE ELECTRIC TEAM.
        - [INCLUSIVE WithiN THE TIME PERIOD OF CONSTRUCTION OF THE ROBOT]

## THINGS TO DO.

- 3. APPLICATION AND IMPLENTATION OF THE NAVIGATION AND OBSTACLE Avoidance SYSTEMS ON TO THE TRACTOR.
            - [ 3 WEEKS ]

## Expected outcome on nav system.

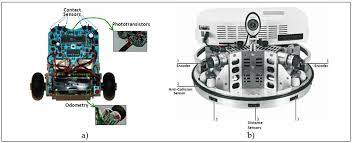
[picture p181: figure]
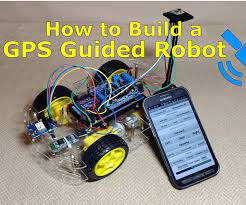
[picture p182: figure]

## 4. Mobile application development

- With the interface needed to control the automated electric tractor, we need an app based input control to key in the needed functionalities;
            - Co-ordinates placing
            - Speed and direction control through pulse width modulation.
            - Location placing and path following control.
            - [ 2 weeks ]
