jibebe-jkuat/internship2023/navigation/gantt.jpeg

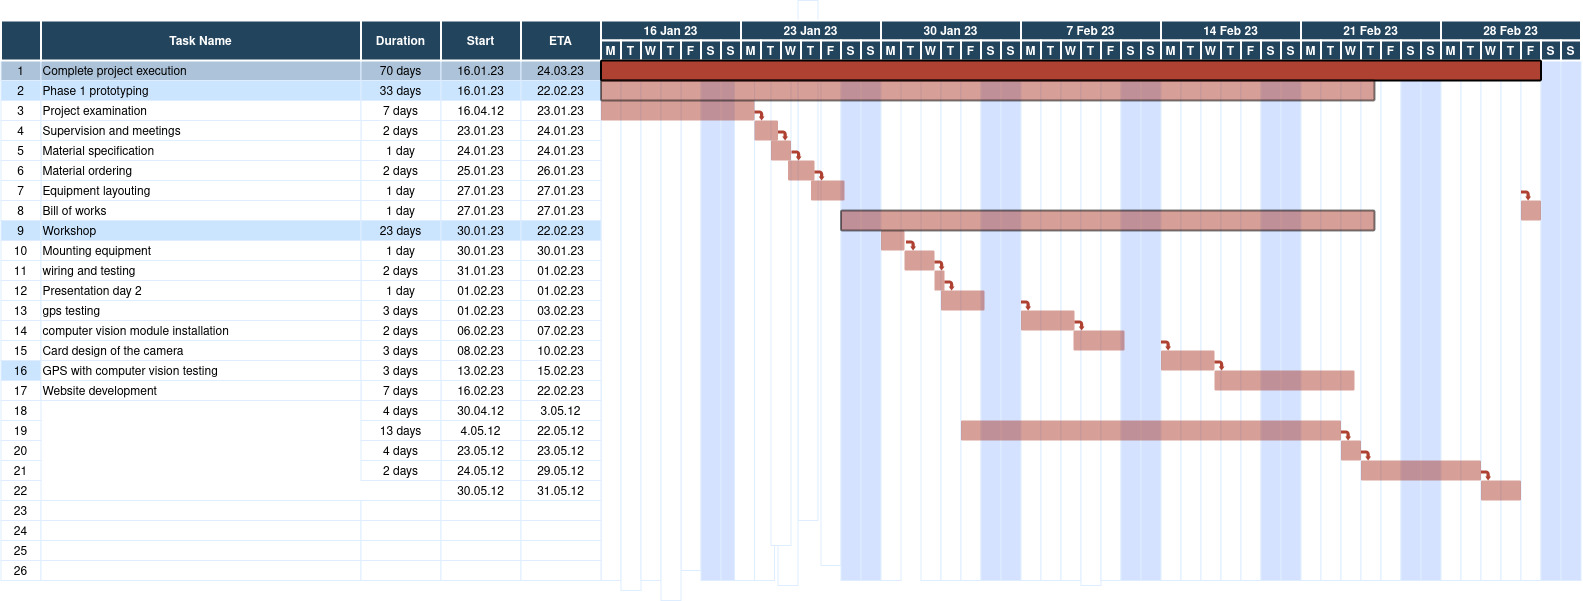
navigation/gantt.jpeg
