jibebe-jkuat/internship2023/(threads)

Thread 3 (2023-01-20):

Find out specification of components

kinuthiiia, 2023-01-20:
Get the motor , battery , charger , tractor and controller specifications to aid in the circuit design process

Thread 4 (2023-01-20):

Come up with High Voltage (HV) and Low Voltage (LV) circuits

kinuthiiia, 2023-01-20:
Research and implement configuring the components ie HV - motor, battery, controller and LV- lights , throttle, navigation systems, brakes

Thread 6 (2023-01-20):

Testing motor & motor controller

kinuthiiia, 2023-01-20:
Testing motor parameters ie. speed , forward & reverse , input current , throttle , braking.

Thread 7 (2023-01-20):

Testing battery performance & charging

kinuthiiia, 2023-01-20:
Test for capacity , charging time , discharging time , output voltage and current and temperature, health.

Thread 8 (2023-01-20):

Determine sensors required

kinuthiiia, 2023-01-20:
We are to find out which sensors are needed for fetching data to display in the end user console. ie - speed , battery capacity sensor, motor temperature and performance sensor.

kinuthiiia, 2023-02-15:
We settled on using an external display due to limited time.

Closed 2023-02-15.

Thread 14 (2023-01-24):

Reconnect wires using terminal cables

Eunice-Orenge, 2023-01-24:
The cables of the controller need to be firmly connected to one another using the terminal connectors so that it can be mechanically strong.

Thread 41 (2023-01-31):

Design and Fabricate power port

laban290210, 2023-01-31:
The power ports are to provide power for different components such as lighting, navigation and any power that varies from the 106 volt provided by the battery

Thread 57 (2023-02-15):

-Obstacle avoidance using Ultrasonic sensor.

Dennis11Bundi, 2023-02-15:

Thread 58 (2023-02-15):

Obstacle avoidance using Raspberry Pie module and pi camera

Dennis11Bundi, 2023-02-15:
