jibebe-jkuat/internship2023/(commit log)

2023-02-15 Uploaded new Gantt chart
    [JIbebe Gantt Chart.xlsx]
2023-02-22 create a folder for mechanical team
    [Mechanical Gantt Chart.xlsx]
